INSA-GEI/gei-nxpcup-4w-pwr/software/alamak_fw_power/documentation/specification/Specification driver I2C.docx

Je vais créer le driver I2C esclave. Laisse-moi d'abord générer les deux fichiers (header + source).Voici le driver complet. Quelques points importants à retenir pour l'intégration :

## Architecture du driver

Machine à états (s_state) avec 4 états : Idle → WaitRegAddr → Writing ou Reading. Le pointeur s_regPtr s'auto-incrémente pour permettre les lectures/écritures multi-octets.

Deux niveaux de callback sont présents dans le .c :

- Le callback SDK (I2CSlave_Callback) — enregistré via LPI2C_SlaveTransferNonBlocking, utilisé si tu souhaites garder l'approche haut niveau SDK.
- L'ISR bas niveau (LP_FLEXCOMM0_IRQHandler) — override du weak handler du SDK, qui gère octet par octet directement via les flags LPI2C. C'est lui qui est actif et qui implémente le protocole réel.

À faire au moment de l'intégration : choisis l'un des deux. Si tu gardes l'ISR bas niveau (recommandé pour ce cas), supprime ou ne lie pas l'appel à LPI2C_SlaveTransferNonBlocking dans I2CSlave_Init.

## Points d'attention

Pins P1.8/P1.9 : le MUX kPORT_MuxAlt3 correspond à LPI2C0 sur le MCXA153 selon le Reference Manual. Vérifie dans ton pin_mux.c généré par MCUXpresso Config Tools si la valeur est différente dans ton projet.

Horloge : CLOCK_SetLpFlexcommClkSrc(0U, kCLOCK_LpFlexCommClkSrc_Fro24M) — l'index 0U correspond à LP_FLEXCOMM0 (= LPI2C0). Confirme le nom de l'enum dans ton SDK avec fsl_clock.h.

Registre ID : conformément au tableau, 0x00 est un registre 8 bits (0xBEEF ne tient pas en 8 bits). Le driver expose GetID_Low() → 0xEF et GetID_High() → 0xBE, et les deux adresses 0x00/0x01 sont en RO. Si le maître lit séquentiellement 0x00 + 0x01 il obtient bien 0xEF 0xBE (little-endian = 0xBEEF).

gI2CChanged : remis à false par l'application après traitement, jamais par le driver.

Usage typique dans main :

I2CSlave_Init();

I2CSlave_SetVBAT(3700U); // 3700 mV

I2CSlave_SetODO1(123456UL);

while (1) {

if (gI2CChanged) {

gI2CChanged = false;

uint16_t mot1 = I2CSlave_GetMOT1();

// traiter la commande...

}

}
