INSA-GEI/gei-nxpcup-4w-pwr/hardware/PDF/Capture du 2026-06-22 18-59-21.png

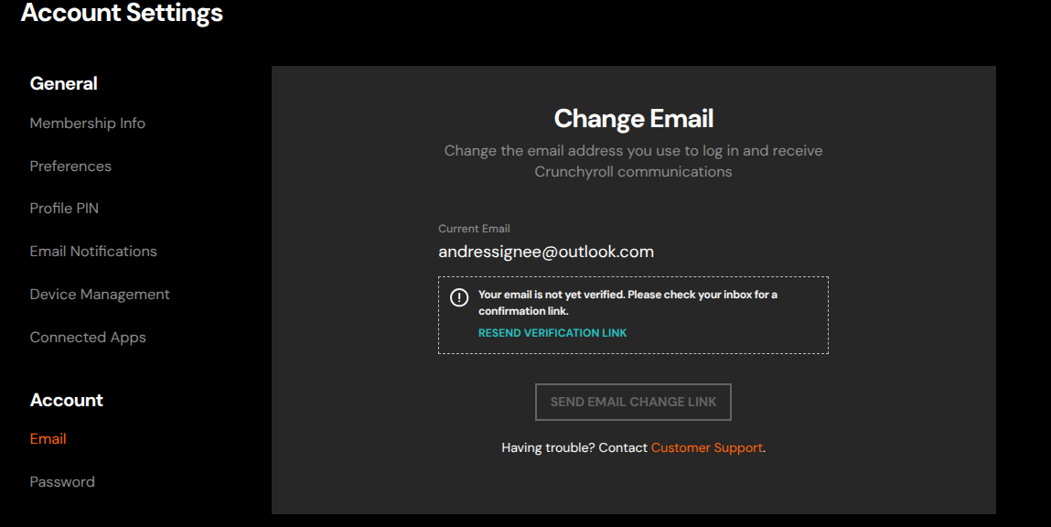
hardware/PDF/Capture du 2026-06-22 18-59-21.png
