INSA-GEI/gei-nxpcup-4w-pwr/hardware/PDF/IO.png

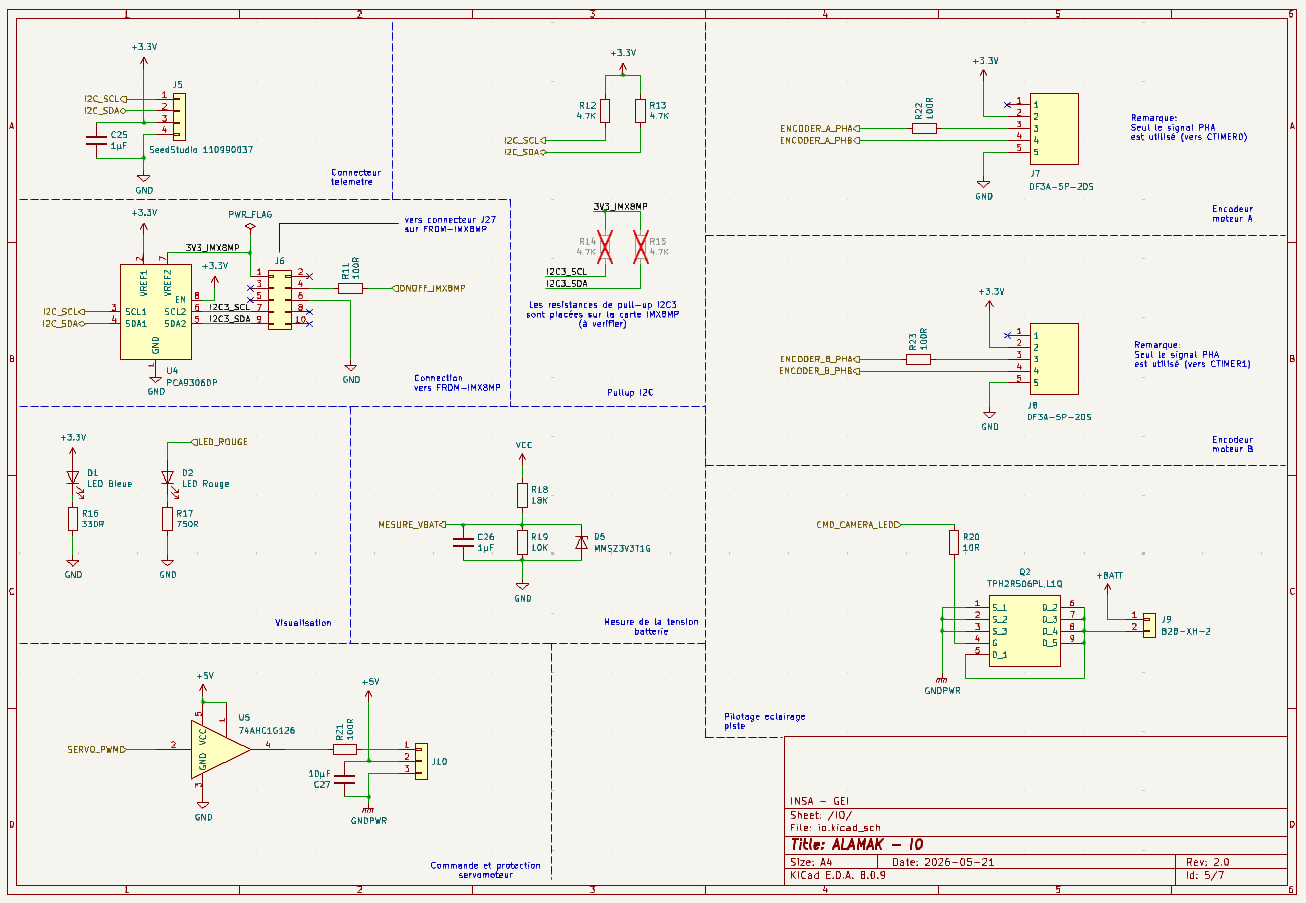
hardware/PDF/IO.png
