INSA-GEI/gei-nxpcup-4w-pwr/hardware/PDF/Puissance.png

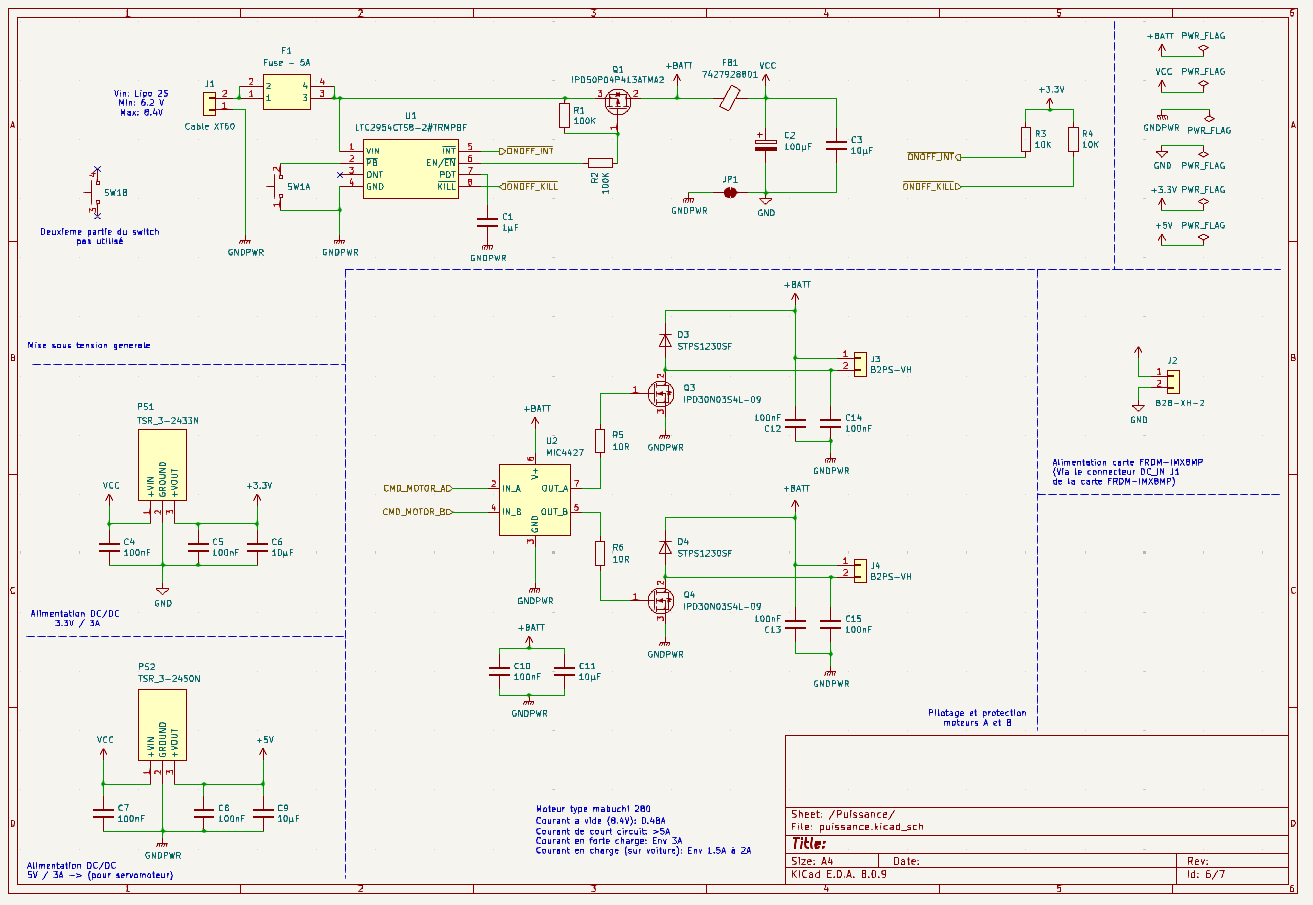
hardware/PDF/Puissance.png
