INSA-GEI/gei-nxpcup-4w-pwr/hardware/PDF/SysML.png

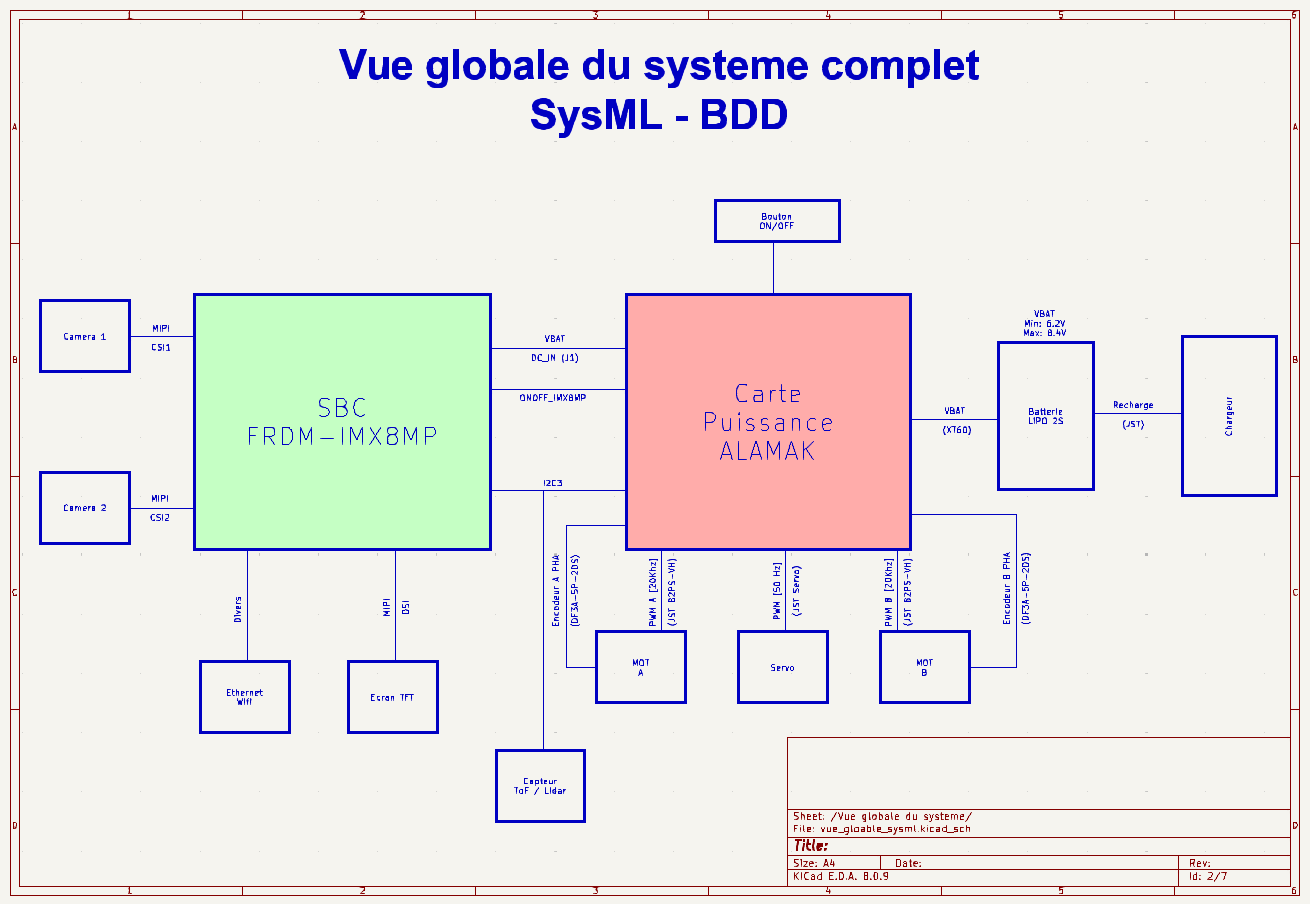
hardware/PDF/SysML.png
