INSA-GEI/gei-nxpcup-4w-pwr/PDF/Carte Alamak - vue globale.png

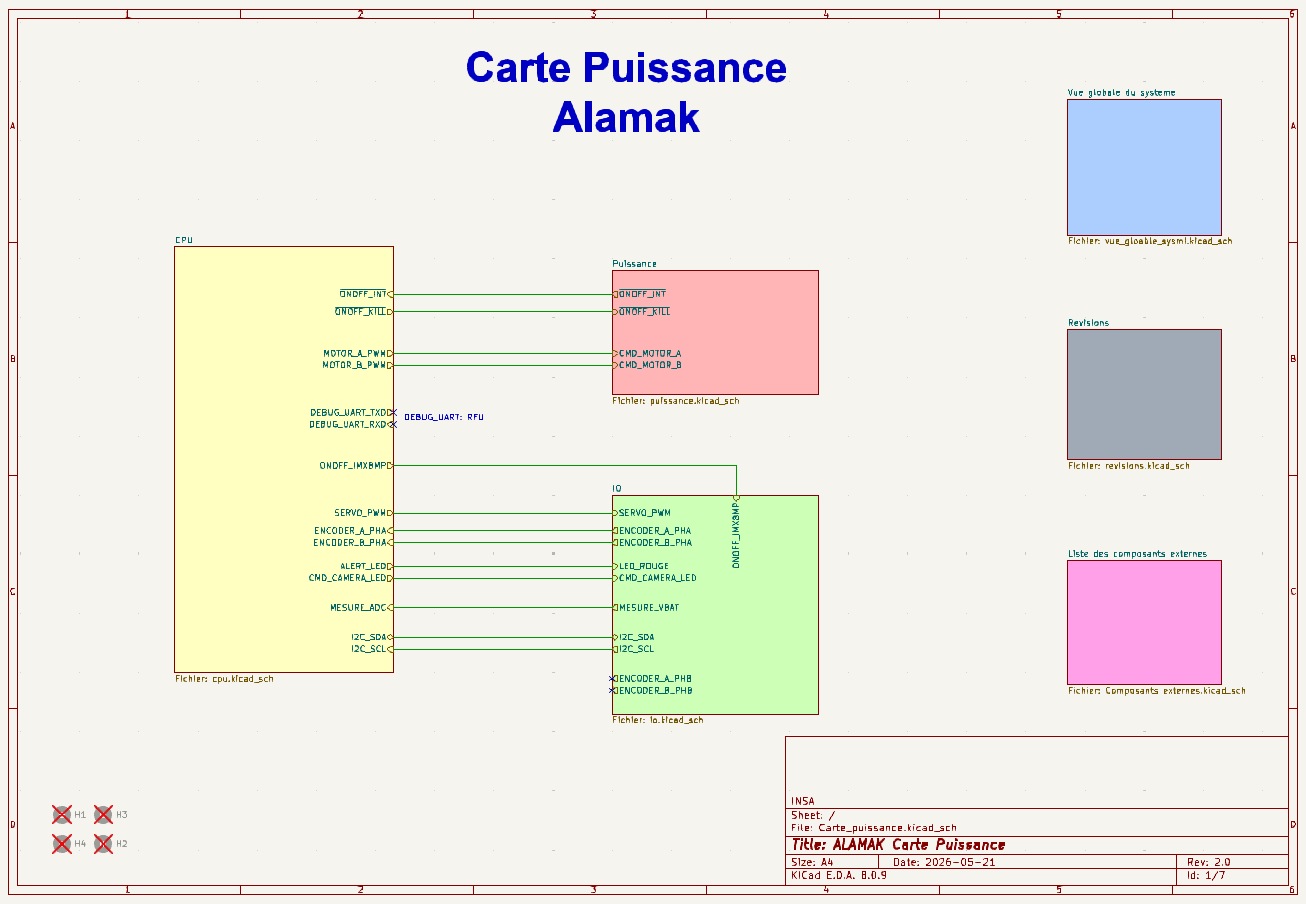
PDF/Carte Alamak - vue globale.png
