INSA-GEI/gei-nxpcup-4w-pwr/PDF/CPU.png

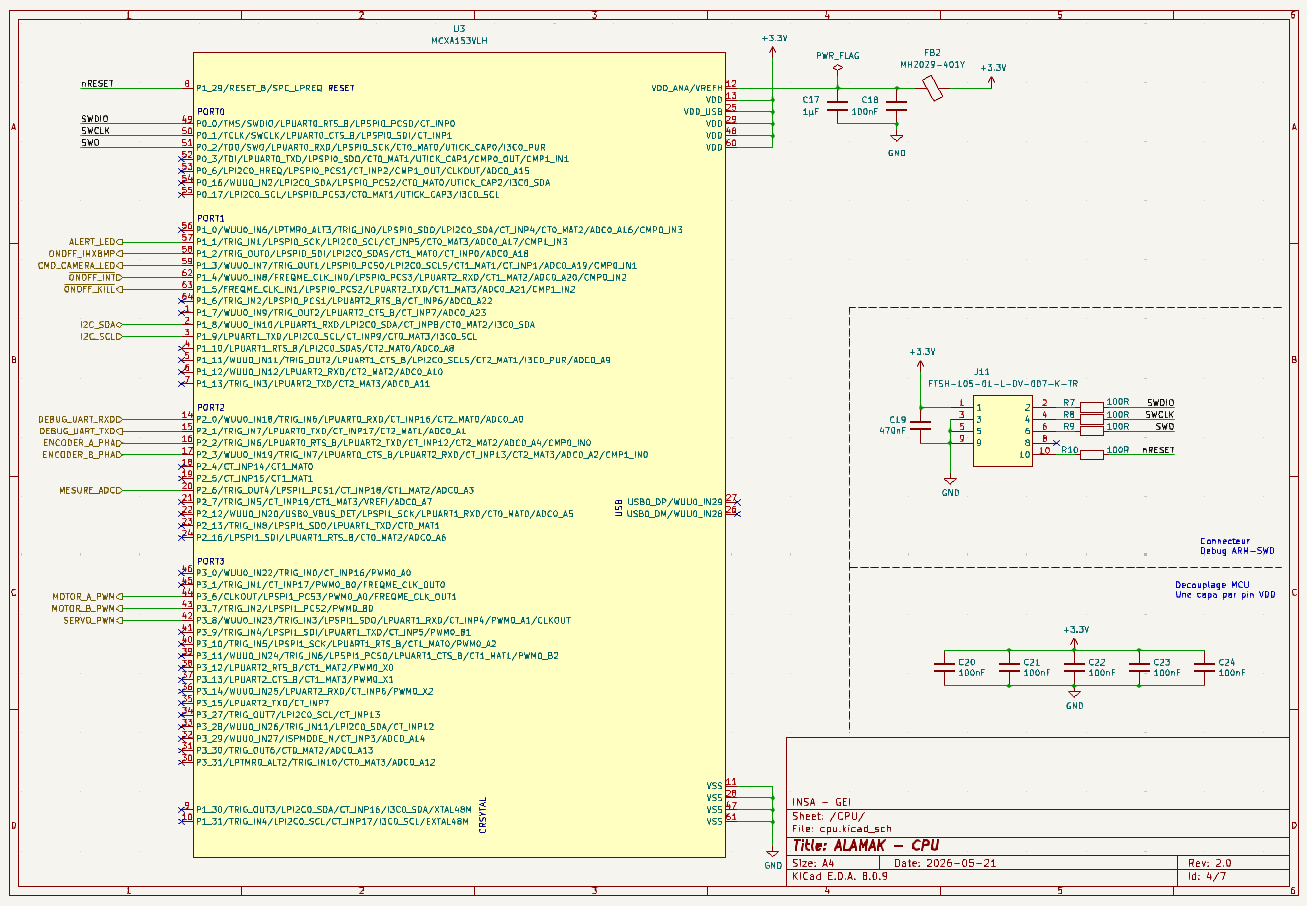
PDF/CPU.png
