INSA-GEI/gei-nxpcup-4w-pwr/PDF/Carte_puissance.pdf

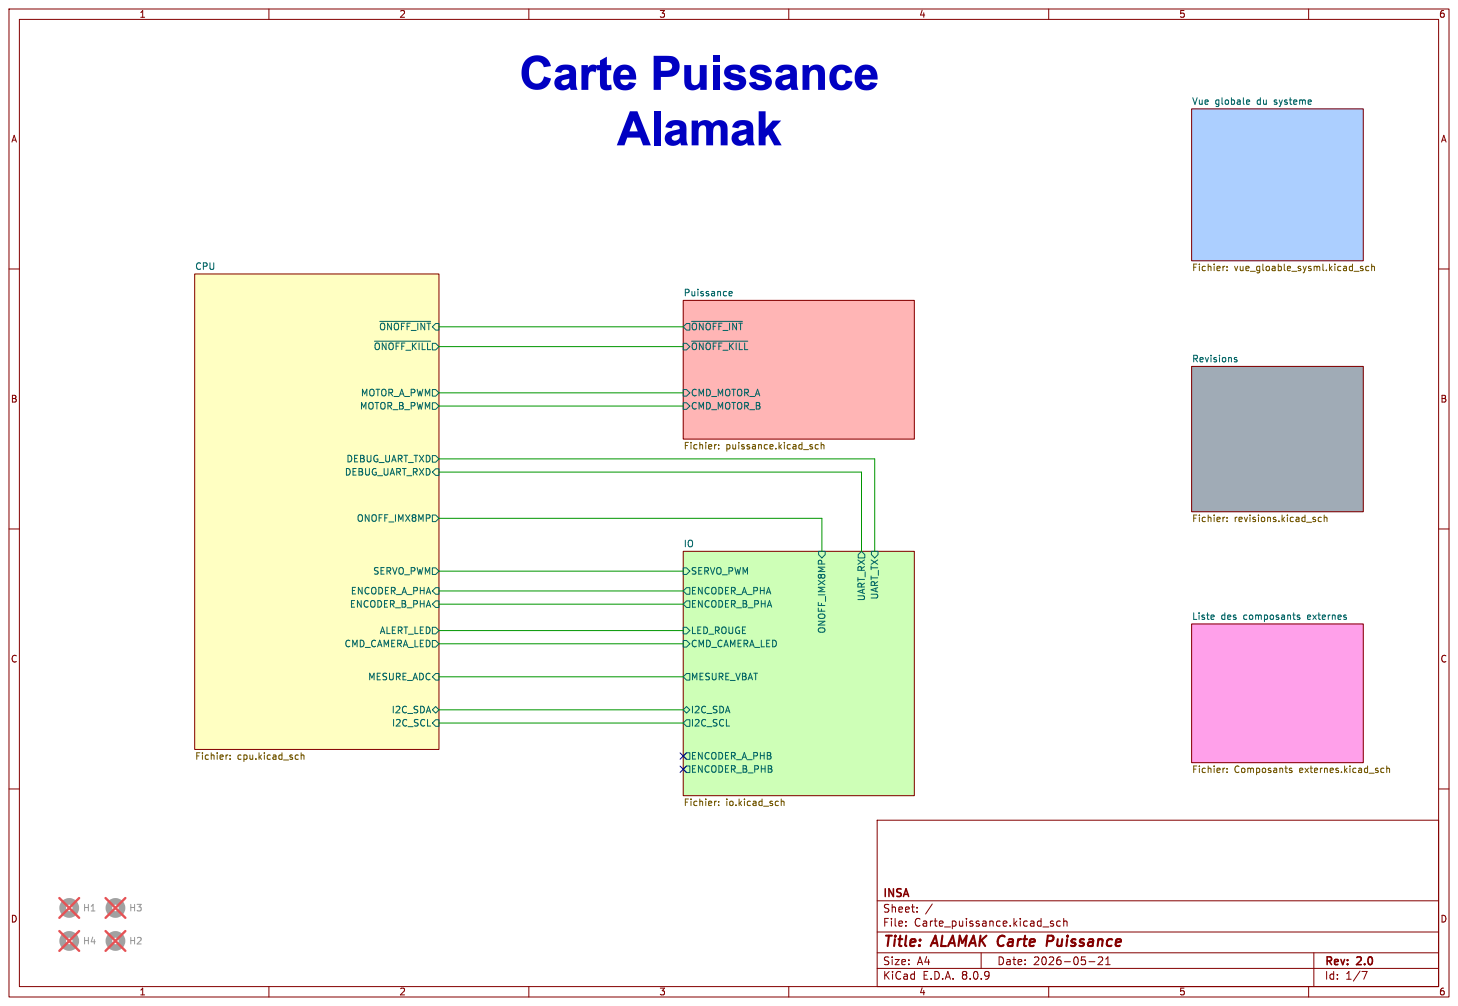
[picture p7: page 1]

INSA
File: Carte_puissance.kicad_sch Sheet: /
Id: 1/7 Title: ALAMAK Carte Puissance

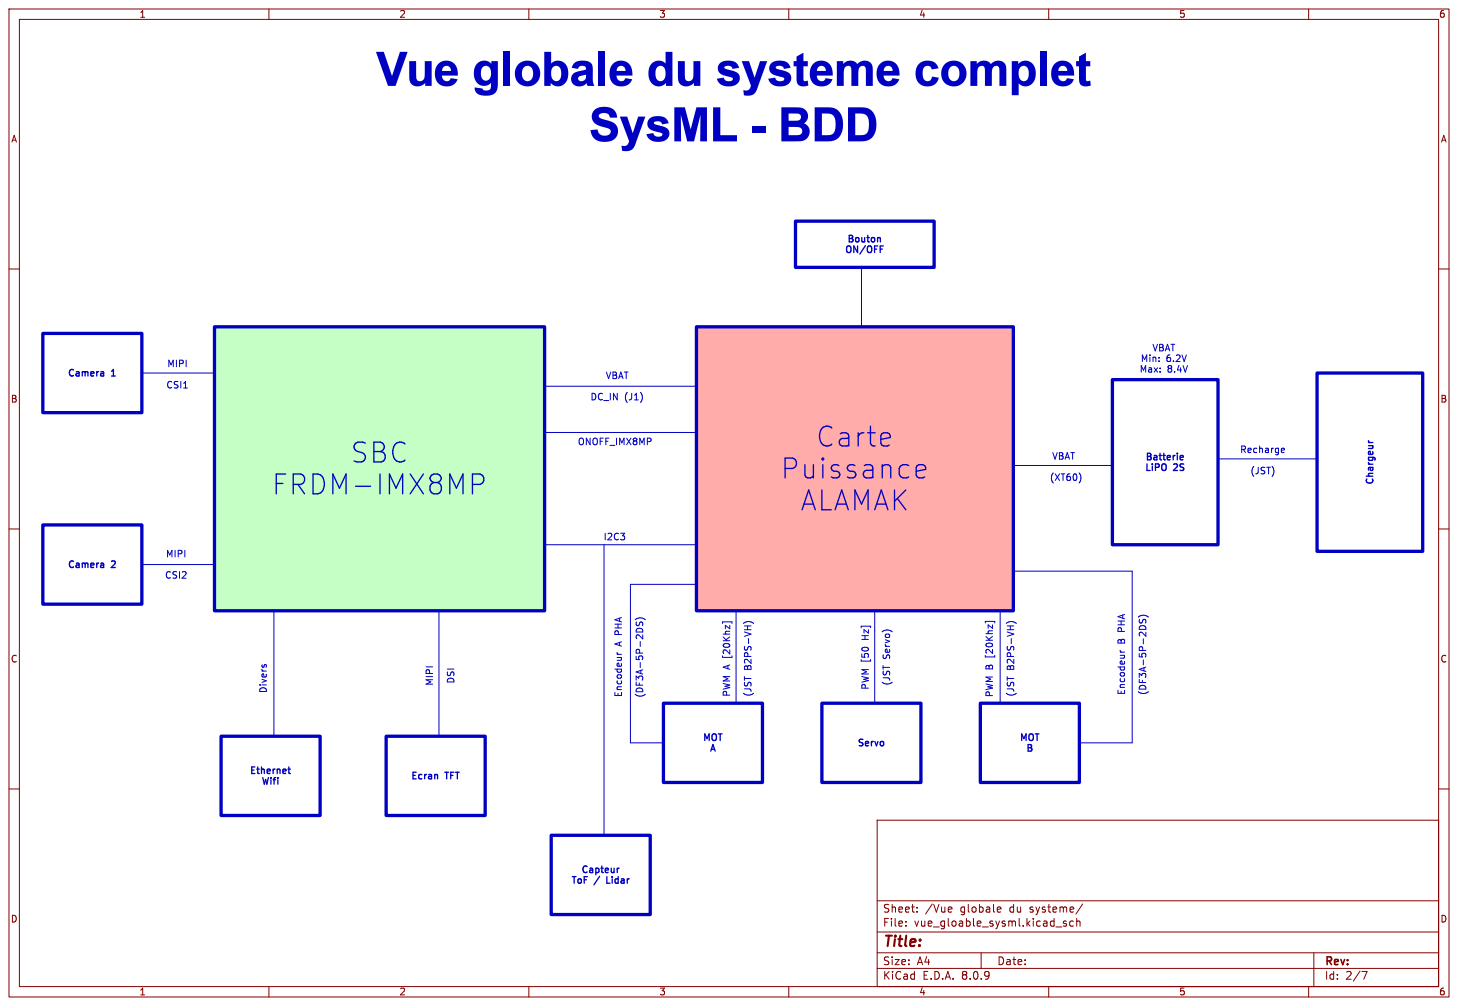
[picture p8: page 2]

(XT60) VBAT DC_IN (J1) ONOFF_IMX8MP Vue globale du systeme complet

(JST) VBAT Min: 6.2V Max: 8.4V

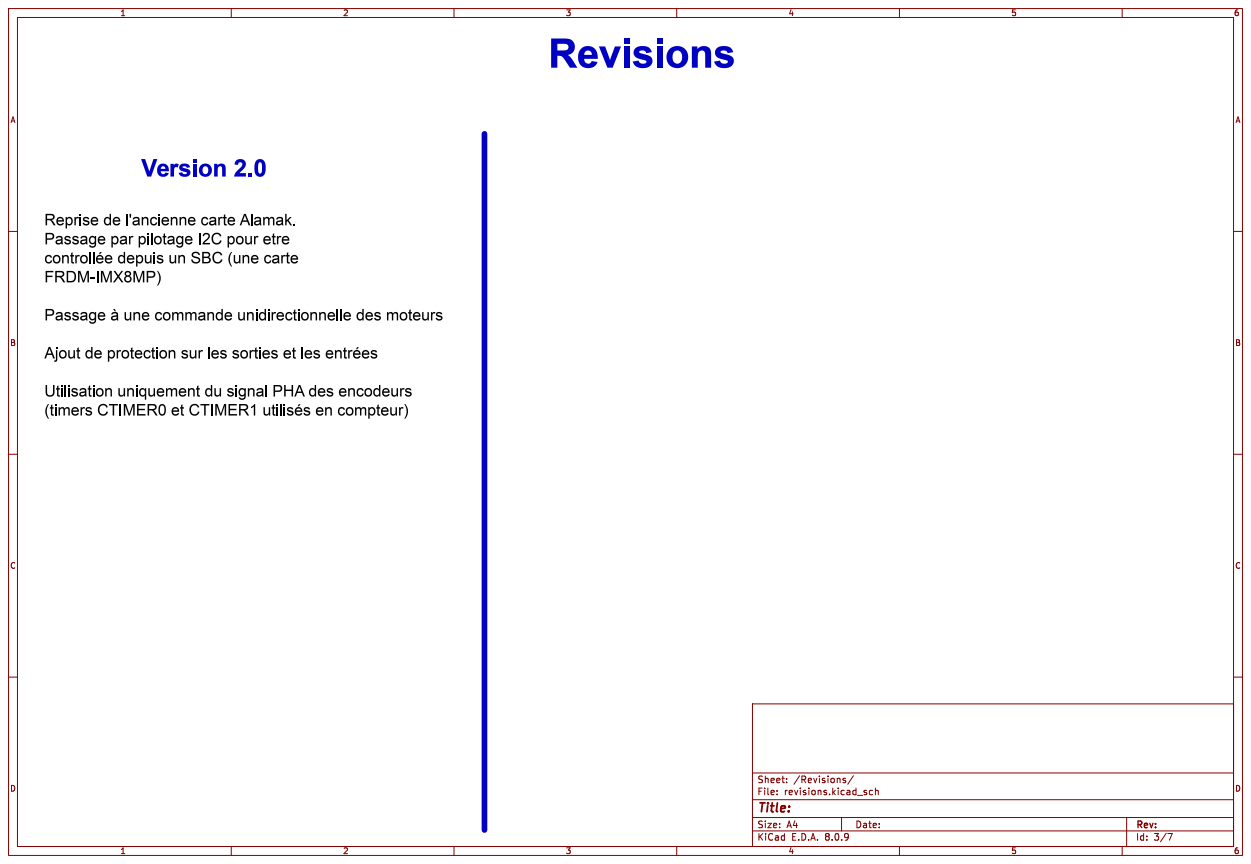
[picture p9: page 3]

Id: 3/7 Title: File: revisions.kicad_sch Sheet: /Revisions/ Reprise de l'ancienne carte Alamak.
Passage par pilotage I2C pour etre
þÿcontrollée depuis un SBC (une carte
FRDM-IMX8MP)

Passage þÿàune commande unidirectionnelle des moteurs

Ajout de protection sur les sorties et les þÿentrées

Utilisation uniquement du signal PHA des encodeurs
(timers CTIMER0 et CTIMER1 þÿutilisés en compteur)

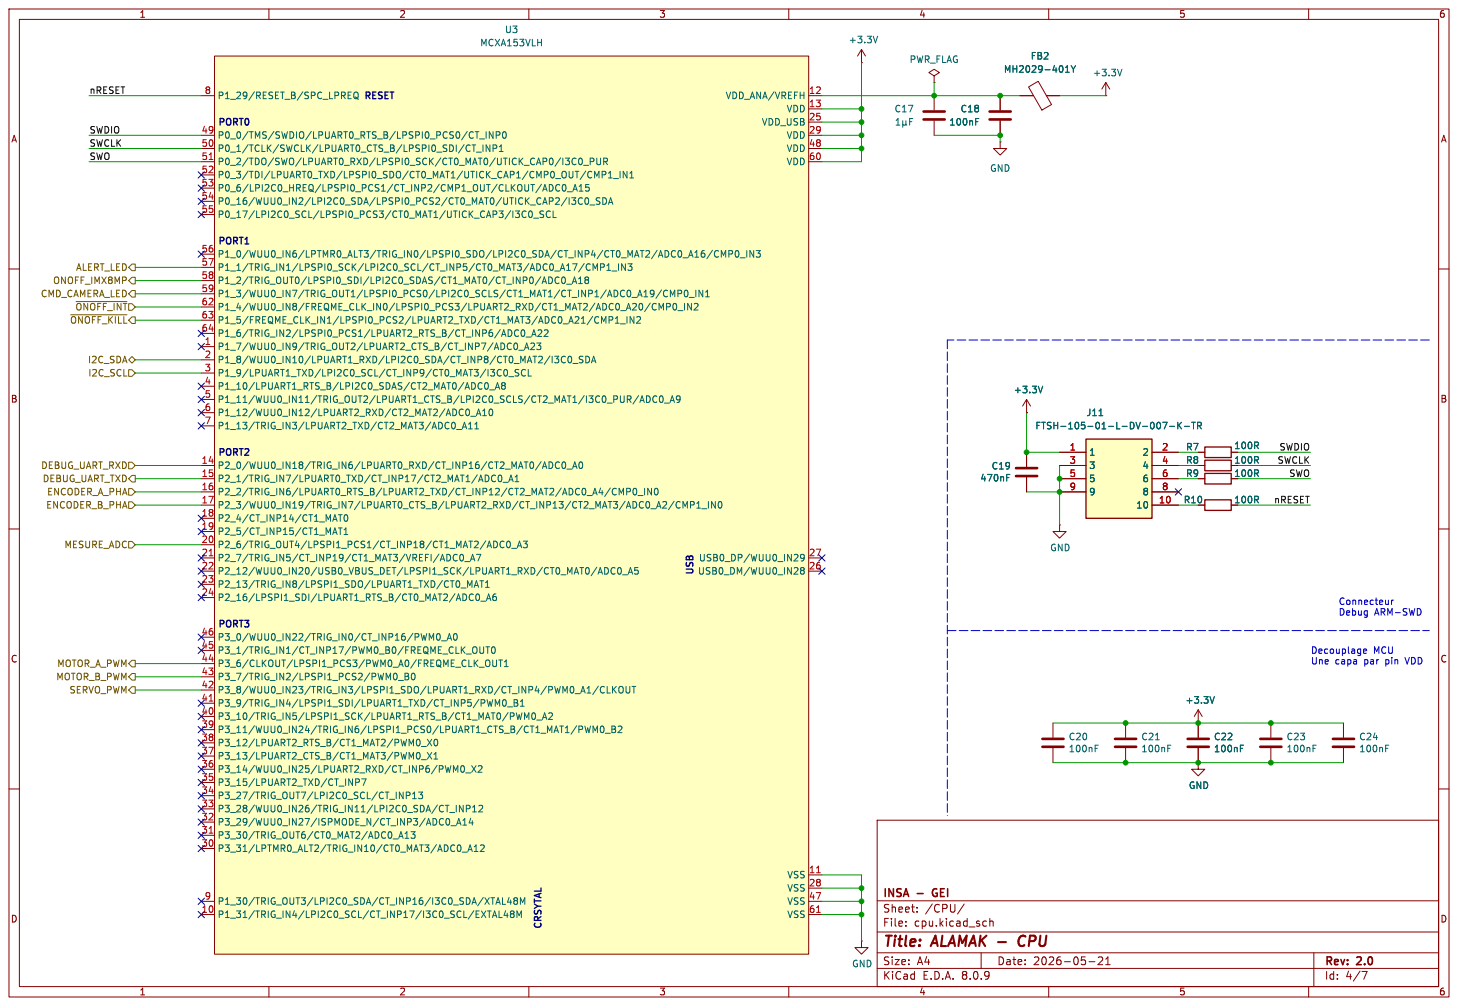
[picture p10: page 4]

Connecteur Debug ARM-SWD GND

Une capa par pin VDD

File: cpu.kicad_sch Sheet: /CPU/
Id: 4/7 Title: ALAMAK - CPU

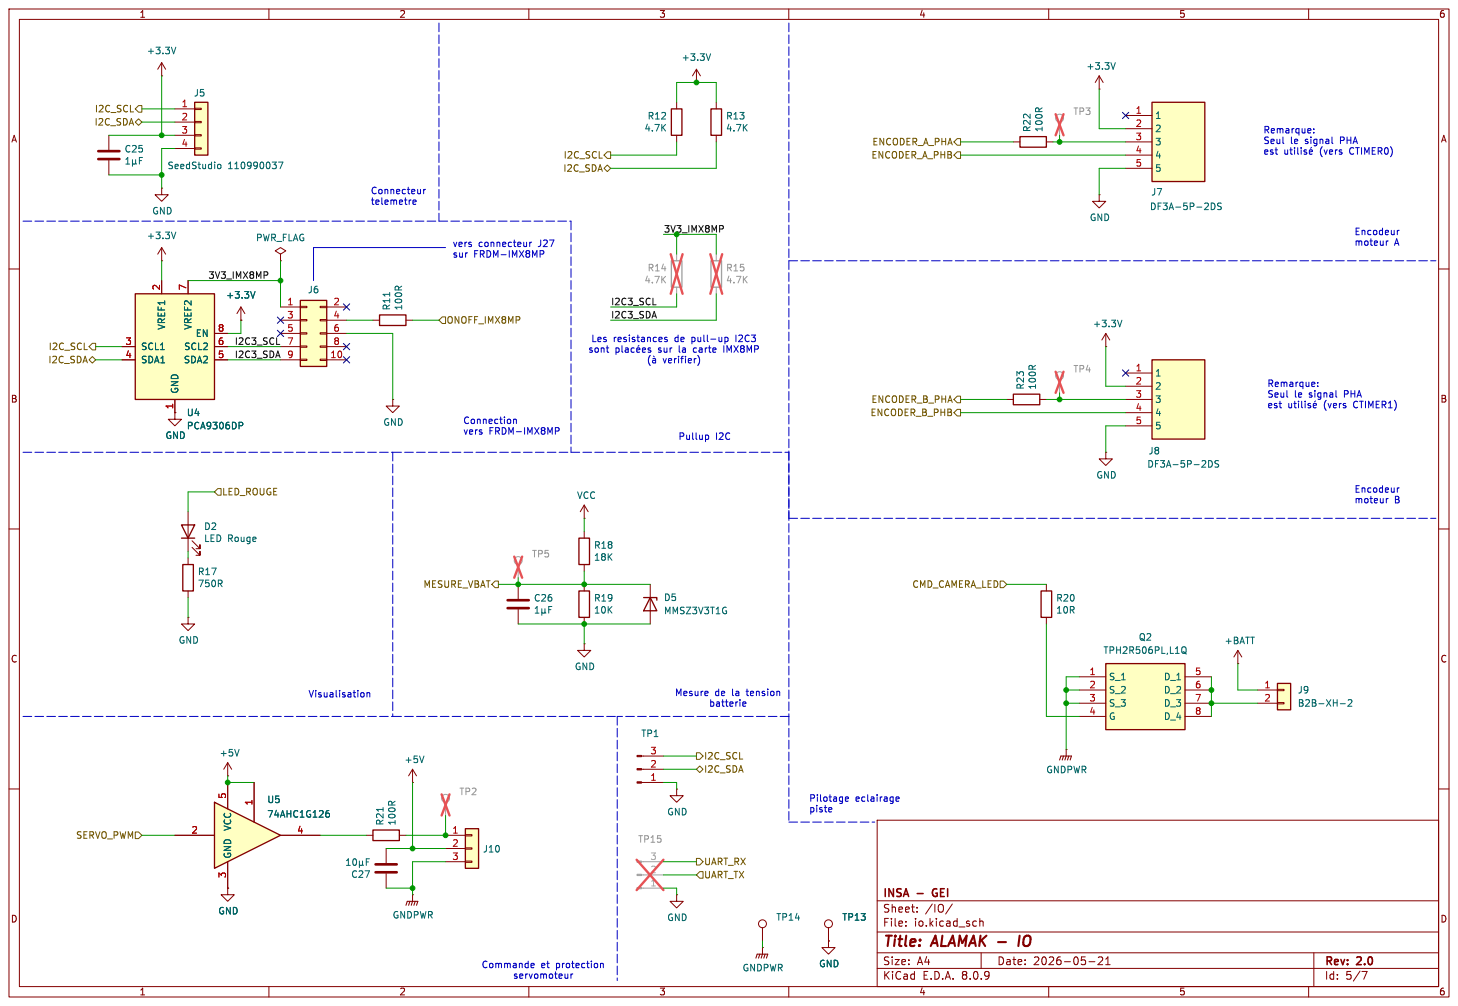
[picture p11: page 5]

Encodeur moteur A Remarque: Seul le signal PHA

sont þÿplacées sur la carte IMX8MP

Remarque: Seul le signal PHA

INSA - GEI
File: io.kicad_sch Sheet: /IO/
Id: 5/7 Title: ALAMAK - IO

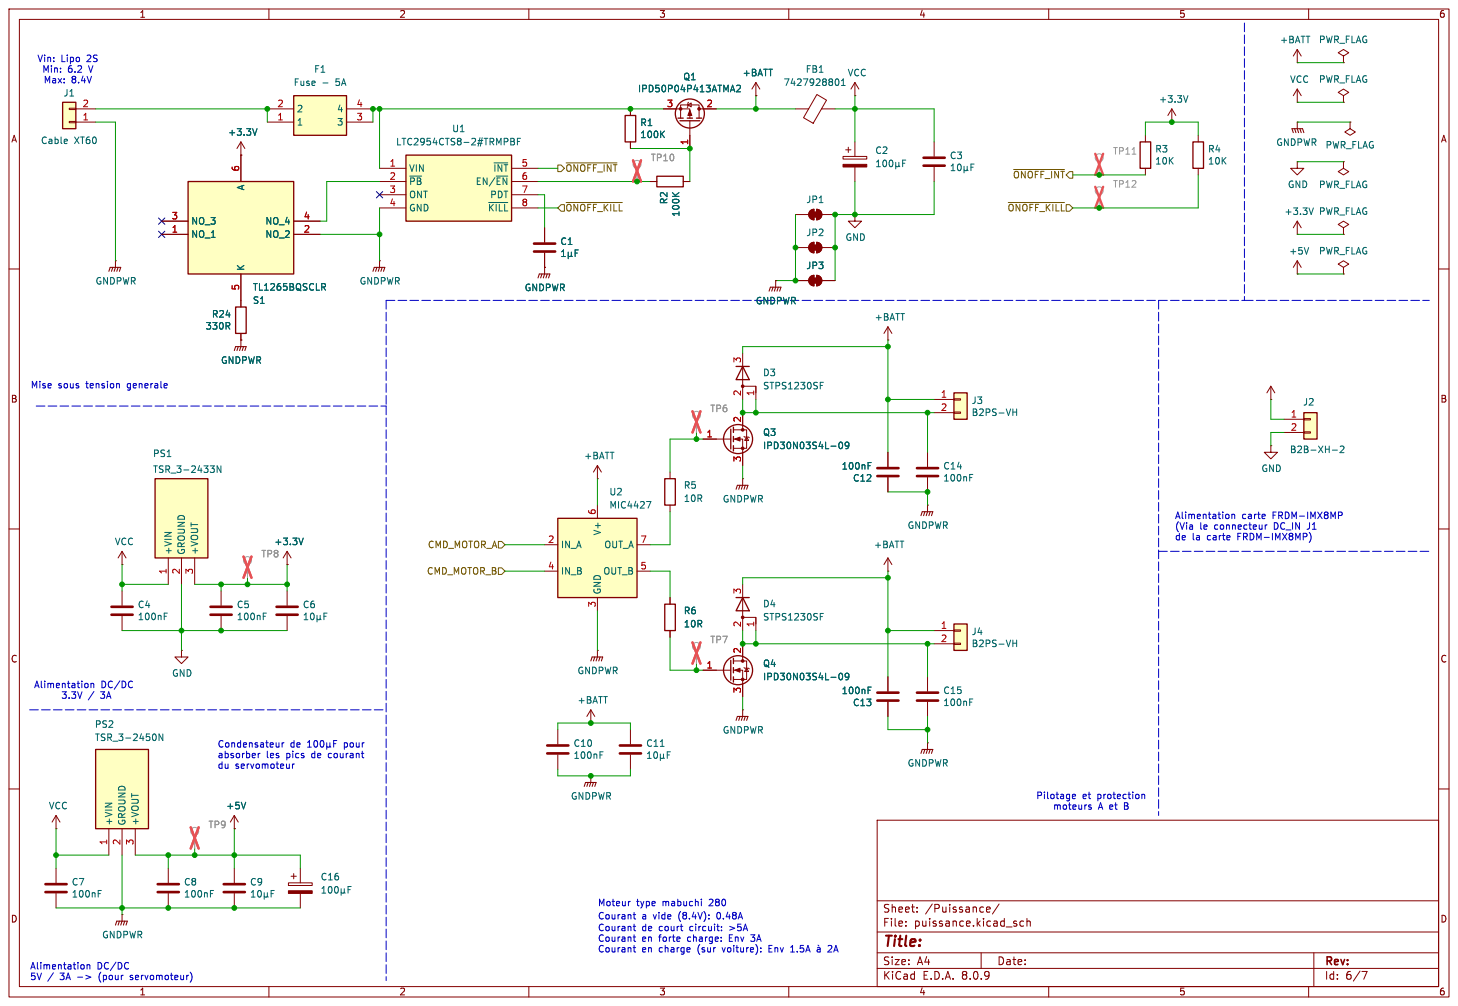
[picture p12: page 6]

6 OUT_A 7 U2 MIC4427 R6
Id: 6/7 Title: File: puissance.kicad_sch Sheet: /Puissance/ GNDPWR GNDPWR

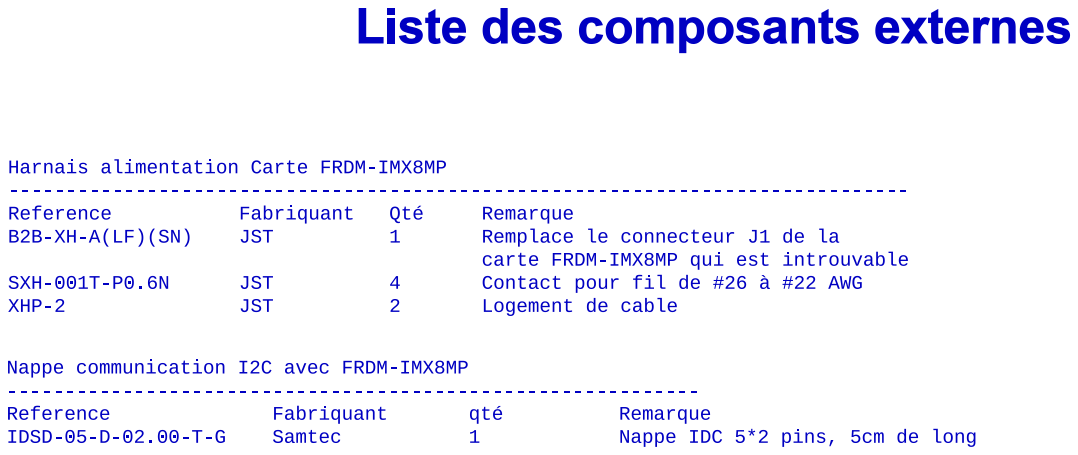
[picture p13: page 7]

Liste des composants externes
