INSA-GEI/gei-nxpcup-4w-pwr/hardware/PDF/PCB.pdf

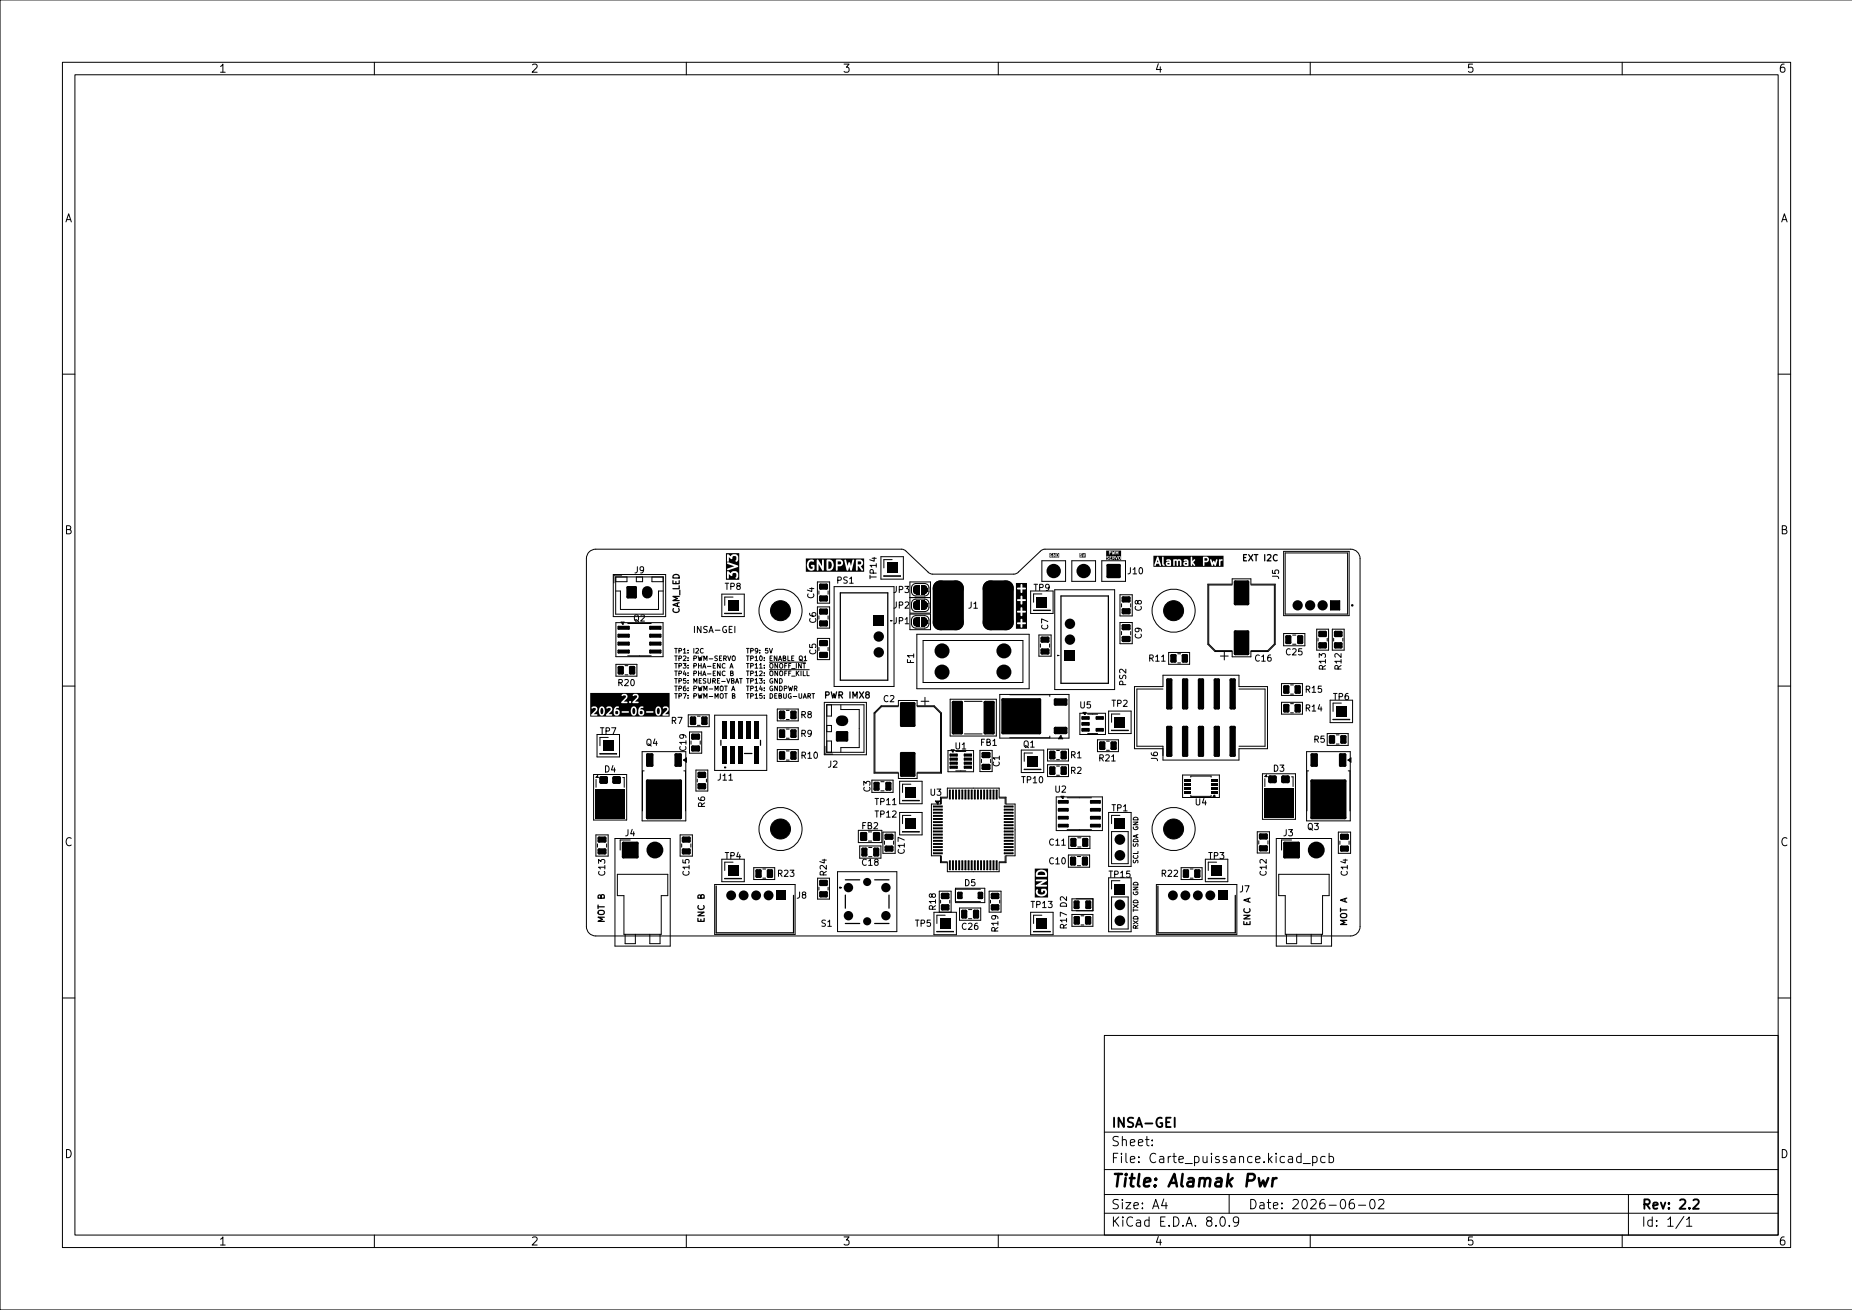
[picture p14: page 1]
