INSA-GEI/gei-nxpcup-4w-pwr/hardware/Carte_puissance.kicad_pcb

## KiCad design hardware/Carte_puissance.kicad_pcb (2026-10-14)

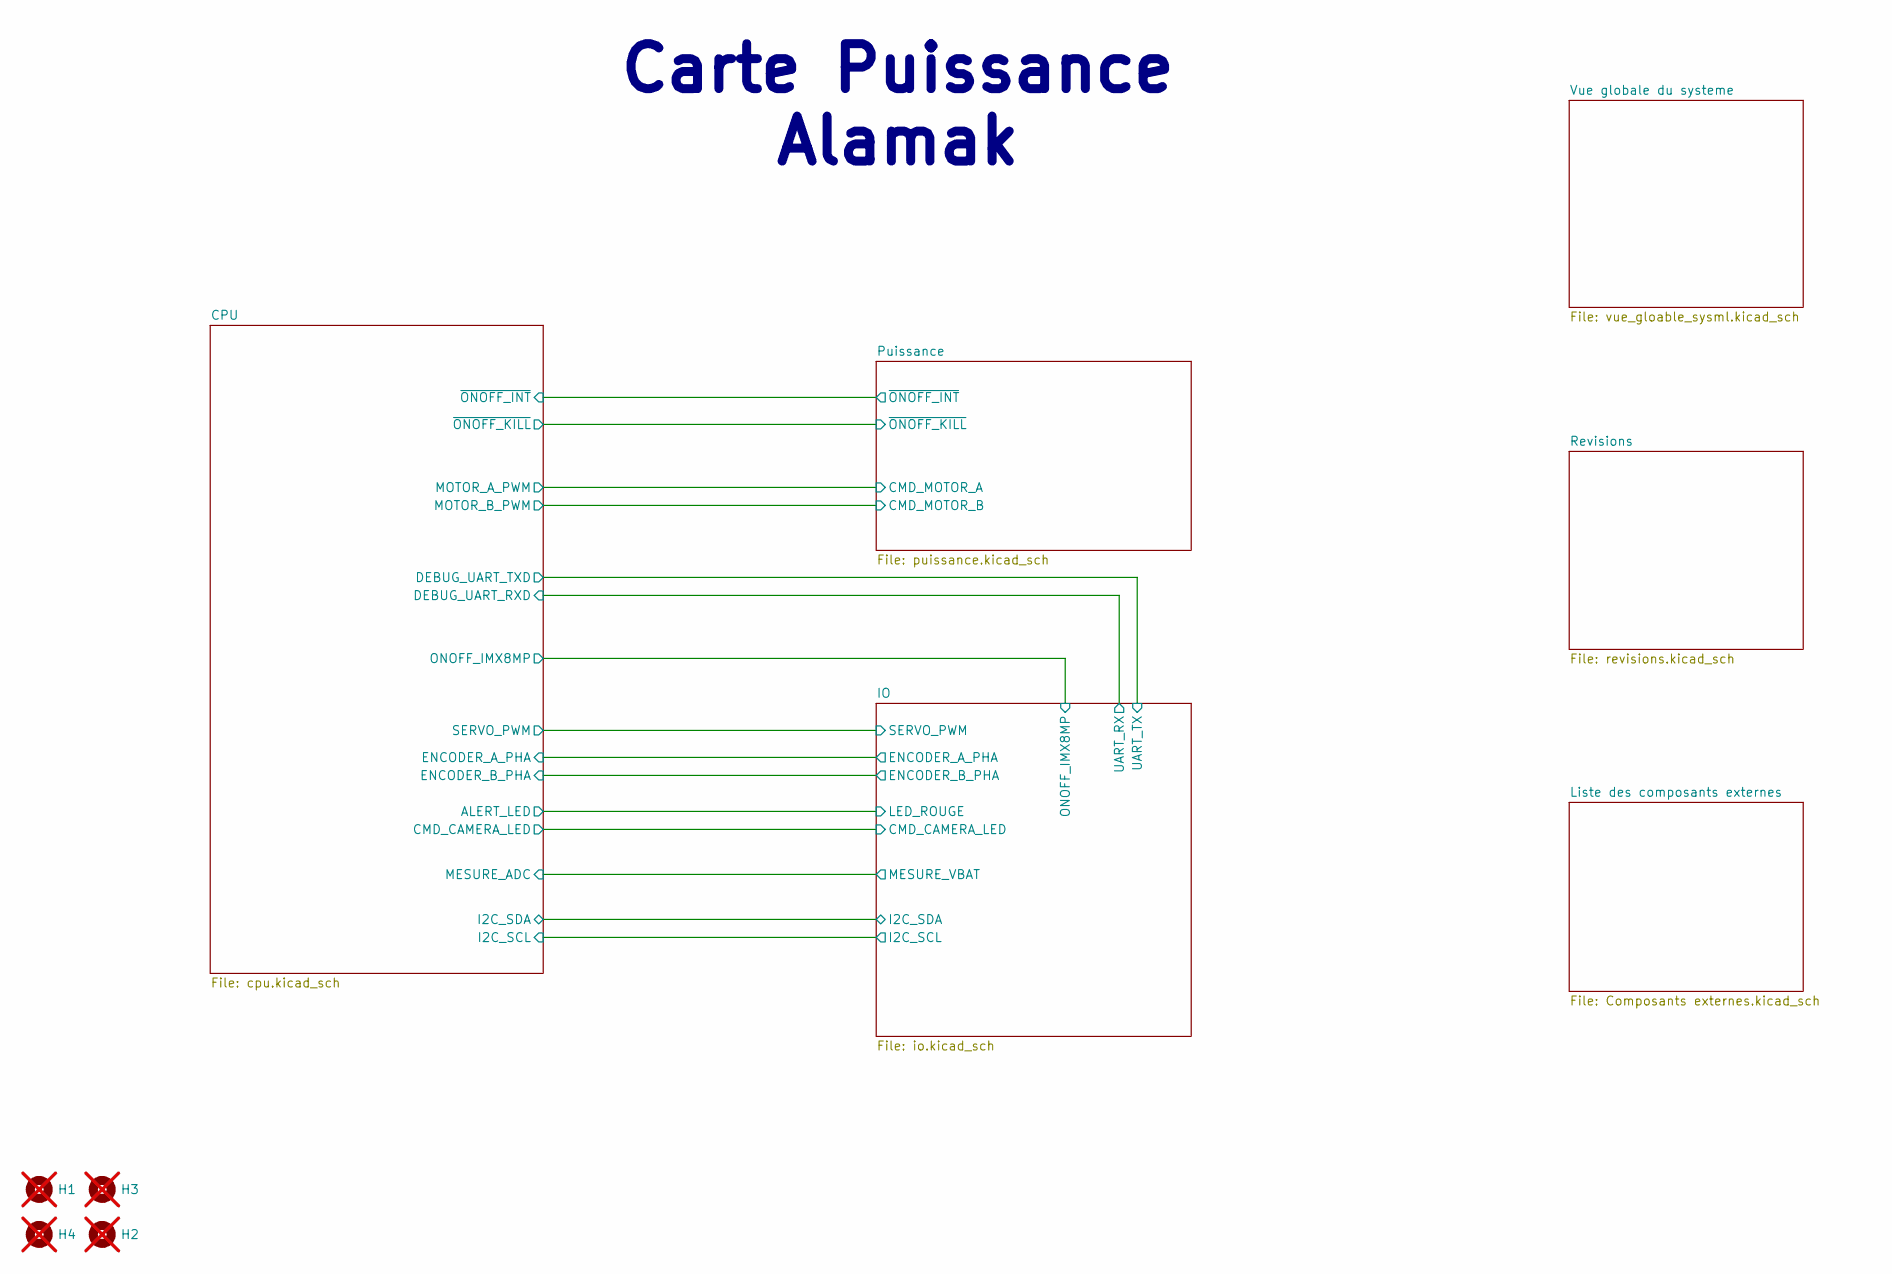
[picture p15: schematic Carte_puissance.kicad_sch, ALAMAK Carte Puissance]

Parts:
H1, H2, H3, H4: MountingHole; MountingHole_3.2mm_M3; not fitted

Notes on the sheet:
Carte Puissance Alamak

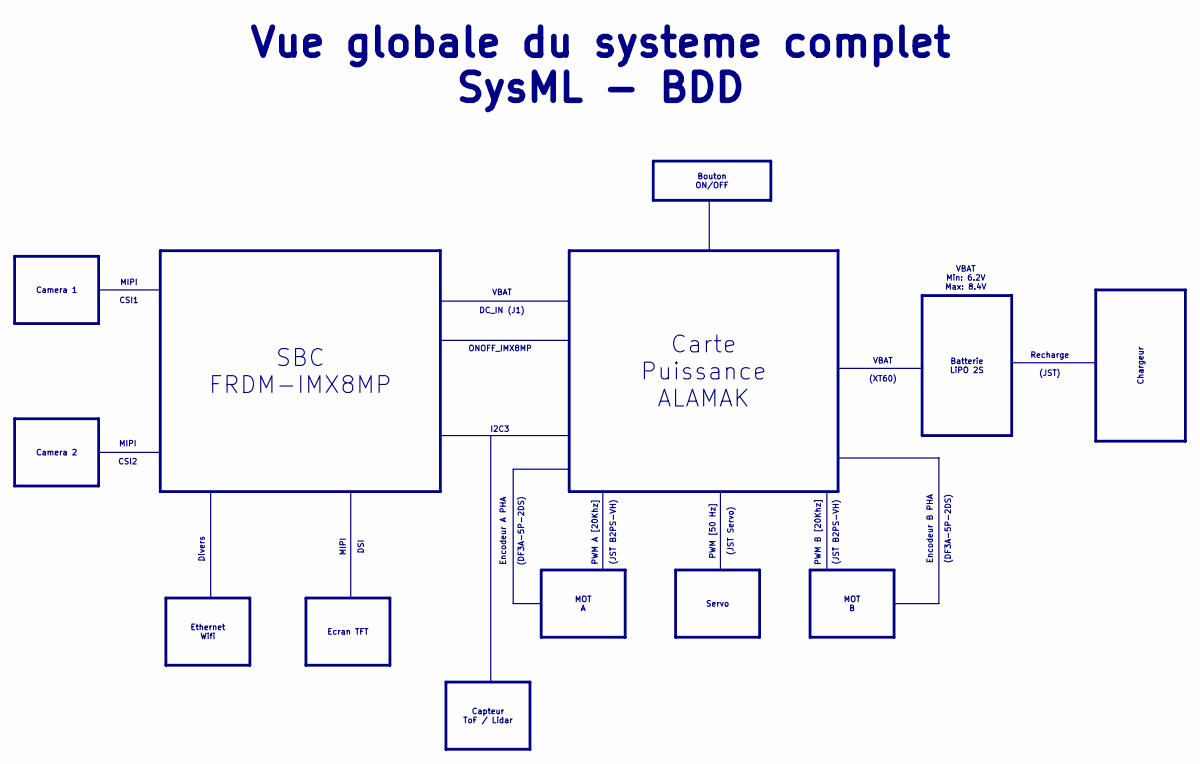
[picture p16: schematic vue_gloable_sysml.kicad_sch]

Notes on the sheet:
Chargeur
Servo
MOT A
MOT B
Ecran TFT
Batterie LiPO 2S
Capteur ToF / Lidar
Ethernet Wifi
SBC FRDM-IMX8MP
Camera 2
Camera 1
Carte Puissance ALAMAK
Bouton ON/OFF
PWM [50 Hz] (JST Servo)
VBAT Min: 6.2V Max: 8.4V
Vue globale du systeme complet SysML - BDD
Encodeur A PHA (DF3A-5P-2DS)
ONOFF_IMX8MP
PWM A [20Khz] (JST B2PS-VH)
MIPI CSI1
VBAT DC_IN (J1)
Divers
Recharge (JST)
VBAT (XT60)
Encodeur B PHA (DF3A-5P-2DS)
I2C3
MIPI CSI2
PWM B [20Khz] (JST B2PS-VH)
MIPI DSI

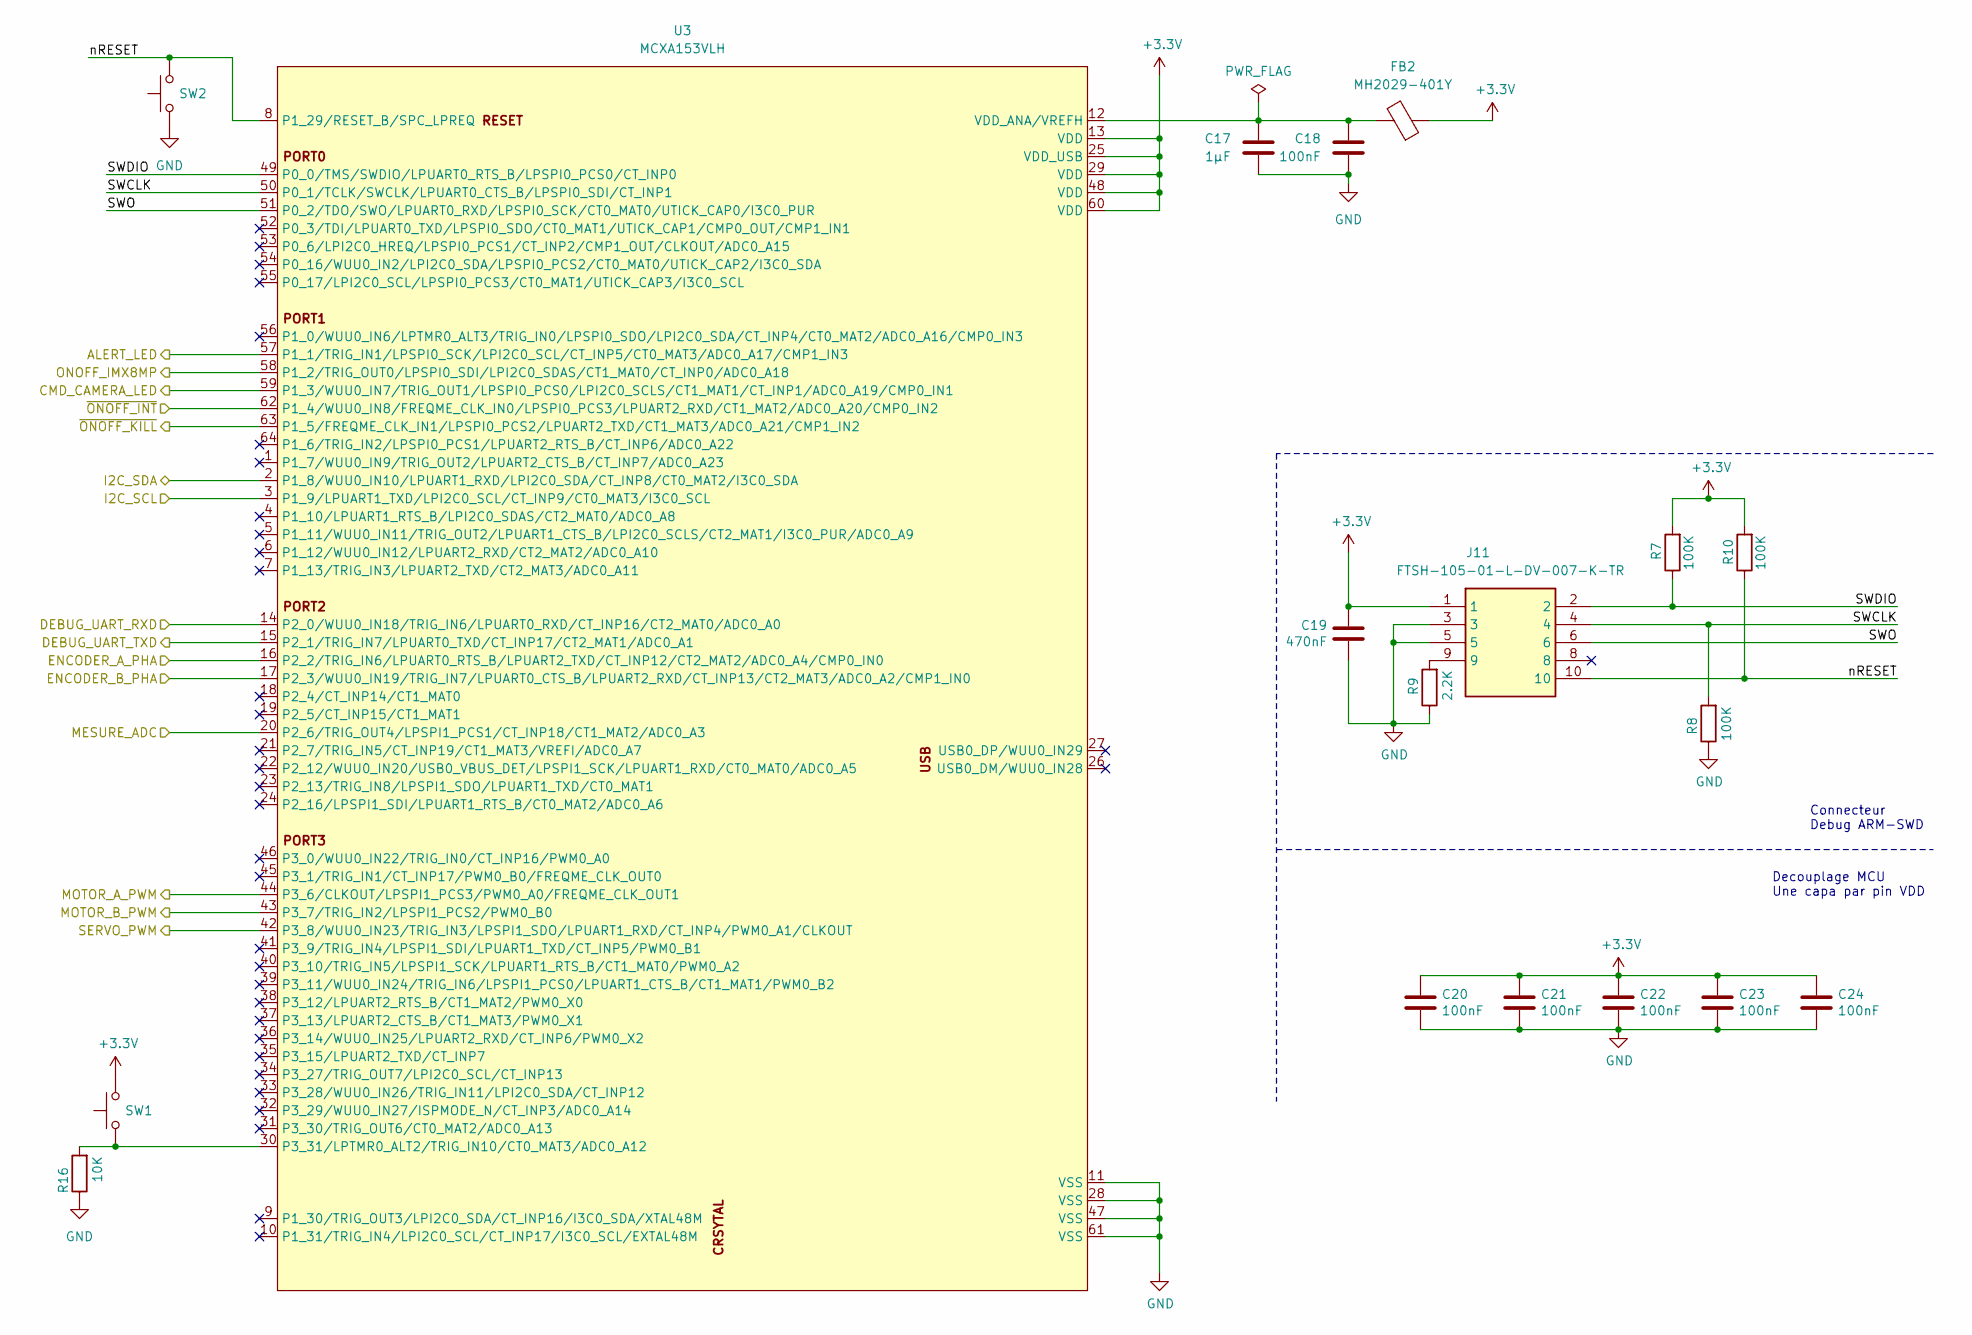
[picture p17: schematic cpu.kicad_sch, ALAMAK - CPU]

Parts:
C17: 1µF; C_0805_2012Metric; Part Number CL21B105KBFNNNF
C18, C20, C21, C22, C23, C24: 100nF; C_0805_2012Metric; Part Number CL21B104KBFNNNG
C19: 470nF; C_0805_2012Metric; Part Number CL21B474KBFNNNG
FB2: MH2029-401Y; C_0805_2012Metric_Pad1.18x1.45mm_HandSolder; Part Number MH2029-401Y
J11: FTSH-105-01-L-DV-007-K-TR; FTSH10501LDV007KTR; Part Number FTSH-105-01-L-DV-007-K-TR
R7, R8, R10: 100K; R_0805_2012Metric; Part Number RT0805FRE10100KL
R9: 2.2K; R_0805_2012Metric; Part Number RT0805FRE132K2L
R16: 10K; R_0805_2012Metric; Part Number RCA080510K0JNEASR
SW1, SW2: EVQ-P2602M; SW_SPST_EVQP2; Part Number EVQ-P2602M
U3: MCXA153VLH; LQFP-64_10x10mm_P0.5mm; Part Number MCXA153VLH

Connections:
+3.3V: C19.1, C20.1, C21.1, C22.1, C23.1, C24.1, FB2.1, J11.1, R7.2, R10.2, SW1.2, U3.13 (VDD), U3.25 (VDD_USB), U3.29 (VDD), U3.48 (VDD), U3.60 (VDD); also elsewhere on the board
/CPU/ALERT_LED: U3.57 (P1_1/TRIG_IN1/LPSPI0_SCK/LPI2C0_SCL/CT_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); also elsewhere on the board
/CPU/CMD_CAMERA_LED: U3.59 (P1_3/WUU0_IN7/TRIG_OUT1/LPSPI0_PCS0/LPI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); also elsewhere on the board
/CPU/DEBUG_UART_RXD: U3.14 (P2_0/WUU0_IN18/TRIG_IN6/LPUART0_RXD/CT_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); also elsewhere on the board
/CPU/DEBUG_UART_TXD: U3.15 (P2_1/TRIG_IN7/LPUART0_TXD/CT_INP17/CT2_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); also elsewhere on the board
/CPU/ENCODER_A_PHA: U3.16 (P2_2/TRIG_IN6/LPUART0_RTS_B/LPUART2_TXD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); also elsewhere on the board
/CPU/ENCODER_B_PHA: U3.17 (P2_3/WUU0_IN19/TRIG_IN7/LPUART0_CTS_B/L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); also elsewhere on the board
/CPU/I2C_SCL: U3.3 (P1_9/LPUART1_TXD/LPI2C0_SCL/CT_INP9/CT0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); also elsewhere on the board
/CPU/I2C_SDA: U3.2 (P1_8/WUU0_IN10/LPUART1_RXD/LPI2C0_SDA/C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); also elsewhere on the board
/CPU/MESURE_ADC: U3.20 (P2_6/TRIG_OUT4/LPSPI1_PCS1/CT_INP18/CT1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); also elsewhere on the board
/CPU/MOTOR_A_PWM: U3.44 (P3_6/CLKOUT/LPSPI1_PCS3/PWM0_A0/FREQME_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); also elsewhere on the board
/CPU/MOTOR_B_PWM: U3.43 (P3_7/TRIG_IN2/LPSPI1_PCS2/PWM0_B0); also elsewhere on the board
/CPU/ONOFF_IMX8MP: U3.58 (P1_2/TRIG_OUT0/LPSPI0_SDI/LPI2C0_SDAS/C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); also elsewhere on the board
/CPU/SERVO_PWM: U3.42 (P3_8/WUU0_IN23/TRIG_IN3/LPSPI1_SDO/LPUA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); also elsewhere on the board
/CPU/SWCLK: J11.4, R8.2, U3.50 (P0_1/TCLK/SWCLK/LPUART0_CTS_B/LPSPI0_SD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)
/CPU/SWDIO: J11.2, R7.1, U3.49 (P0_0/TMS/SWDIO/LPUART0_RTS_B/LPSPI0_PCS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)
/CPU/SWO: J11.6, U3.51 (P0_2/TDO/SWO/LPUART0_RXD/LPSPI0_SCK/CT0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)
/CPU/nRESET: J11.10, R10.1, SW2.2, U3.8 (P1_29/RESET_B/SPC_LPREQ)
/CPU/~ONOFF_INT: U3.62 (P1_4/WUU0_IN8/FREQME_CLK_IN0/LPSPI0_PCS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); also elsewhere on the board
/CPU/~ONOFF_KILL: U3.63 (P1_5/FREQME_CLK_IN1/LPSPI0_PCS2/LPUART2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); also elsewhere on the board
GND: C17.2, C18.2, C19.2, C20.2, C21.2, C22.2, C23.2, C24.2, J11.3, J11.5, R8.1, R9.1, R16.1, SW2.1, U3.11 (VSS), U3.28 (VSS), U3.47 (VSS), U3.61 (VSS); also elsewhere on the board
unnamed: J11.9, R9.2
unnamed: R16.2, SW1.1, U3.30 (P3_31/LPTMR0_ALT2/TRIG_IN10/CT0_MAT3/AD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)
unnamed: C17.1, C18.1, FB2.2, U3.12 (VDD_ANA/VREFH)

Notes on the sheet:
Decouplage MCU Une capa par pin VDD
Connecteur Debug ARM-SWD

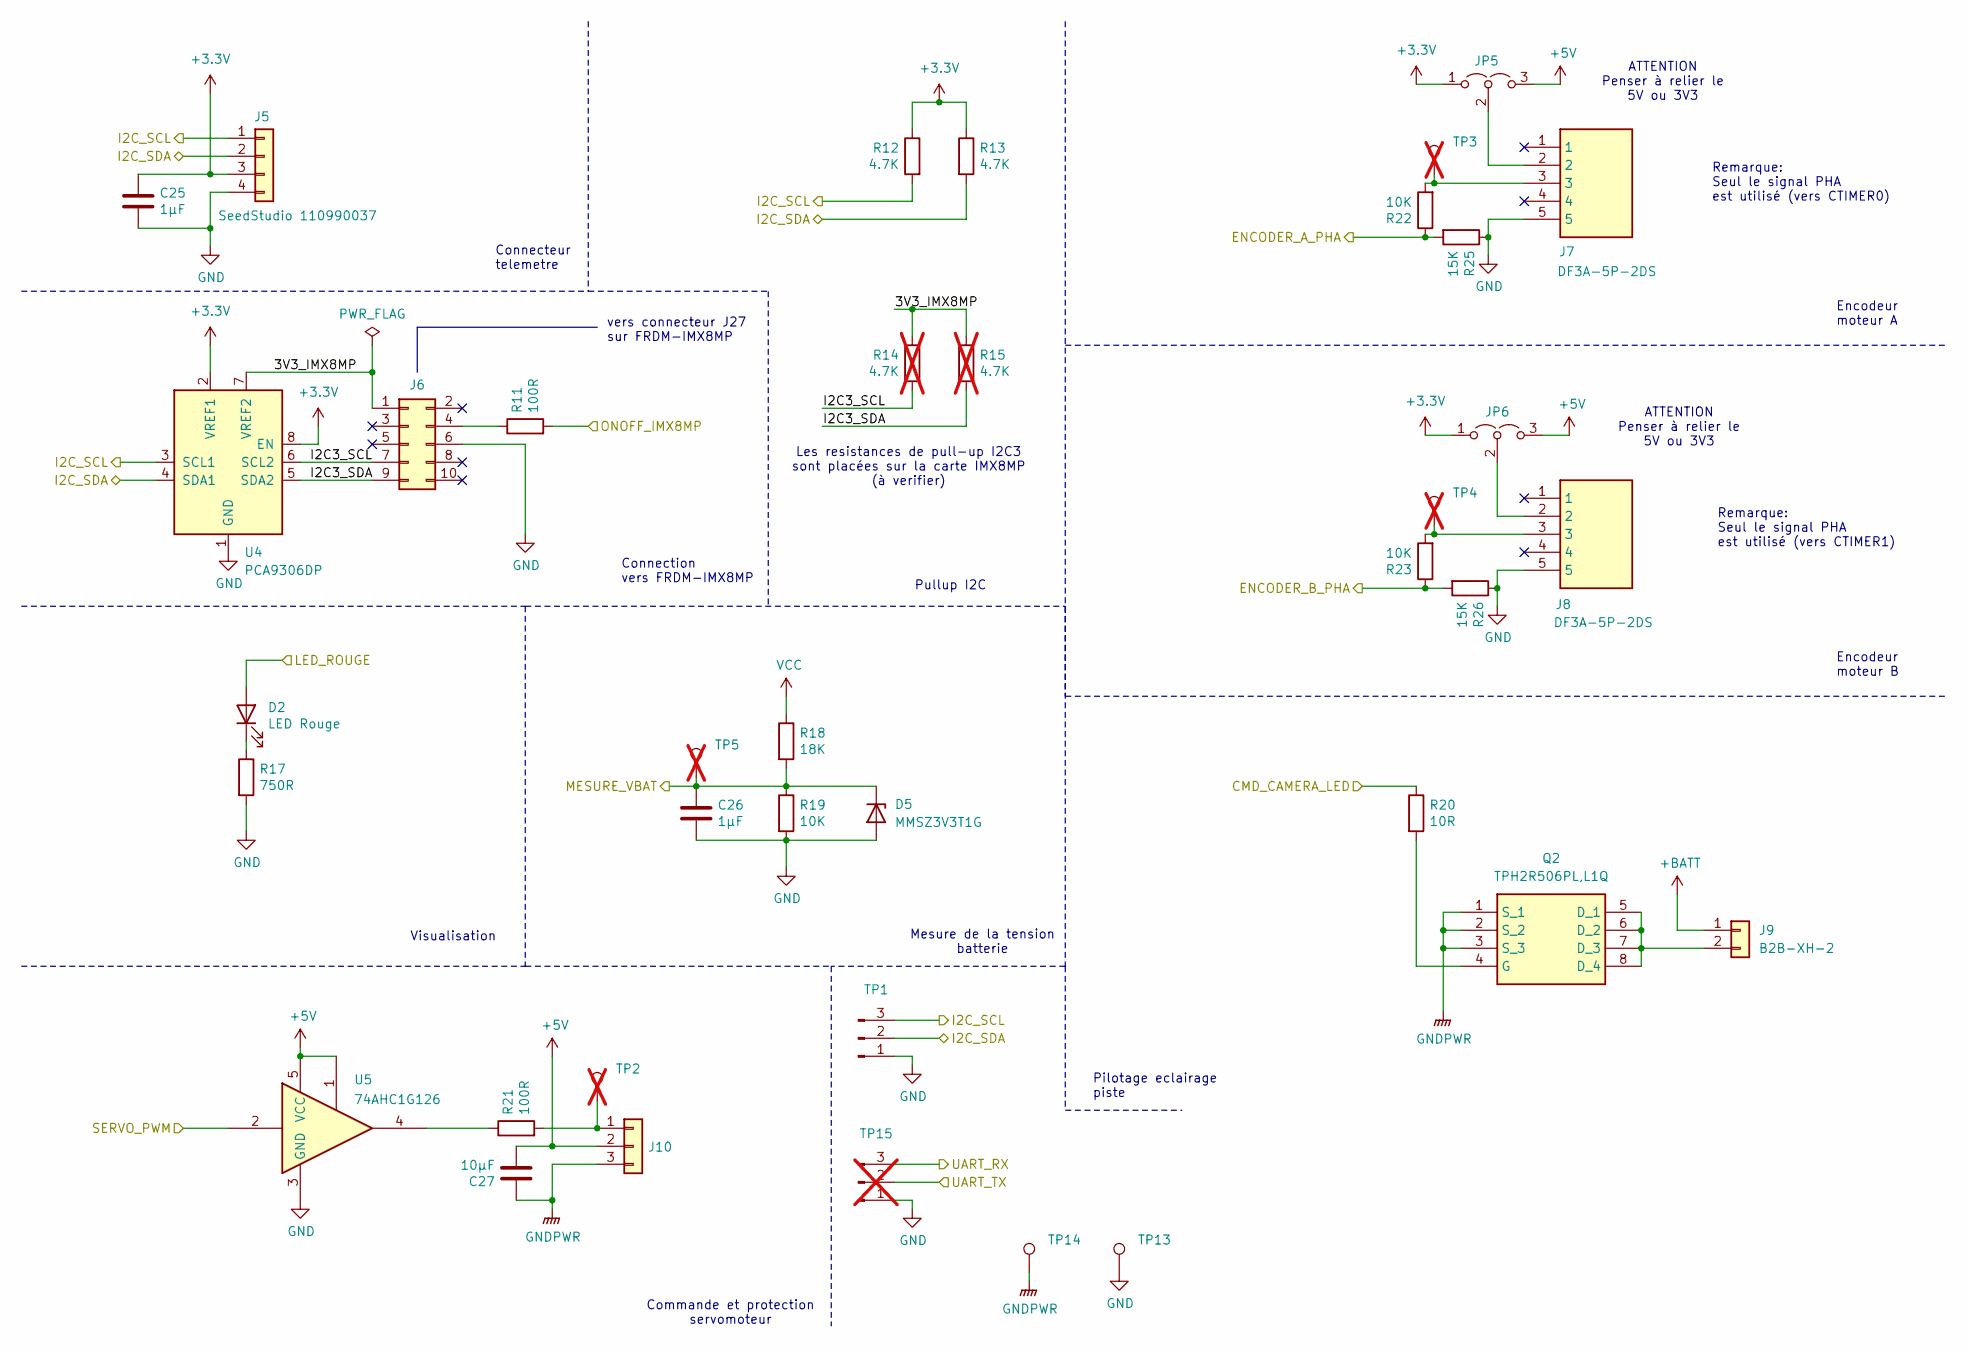
[picture p18: schematic io.kicad_sch, ALAMAK - IO]

Parts:
C25, C26: 1µF; C_0805_2012Metric; Part Number CL21B105KBFNNNF
C27: 10µF; C_0805_2012Metric; Part Number CGA4J1X7S1E106K125AE
D2: LED Rouge; LED_0805_2012Metric; Part Number APTD2012LSURCK
D5: MMSZ3V3T1G; D_SOD-123; Part Number MMSZ3V3T1G
J5: SeedStudio 110990037; SEEED_110990037; Part Number 110990037
J6: 72454-010VLF; IDC-Header_2x05_P2.54mm_Vertical_SMD; Part Number 72454-010VLF
J7, J8: DF3A-5P-2DS; SHDRRA5W60P0X200_1X5_1200X720X530P; Part Number DF3A-5P-2DS
J9: B2B-XH-2; JST_XH_B2B-XH-A_1x02_P2.50mm_Vertical; Part Number B2B-XH-2(LF)(SN)
J10: Cable Servomoteur JST; SolderWire-0.5sqmm_1x03_P4.8mm_D0.9mm_OD2.3mm; Part Number Cable JST Servo
JP5, JP6: Jumper_3_Open; SolderJumper-3_P1.3mm_Open_RoundedPad1.0x1.5mm
Q2: TPH2R506PL,L1Q; SOP-8_3.76x4.96mm_P1.27mm; Part Number TPH2R506PL,L1Q
R11, R21: 100R; R_0805_2012Metric; Part Number RT0805DRE07100RL
R12, R13: 4.7K; R_0805_2012Metric; Part Number RK73H2ATTD4701F
R14, R15: 4.7K; R_0805_2012Metric; Part Number RK73H2ATTD4701F; not fitted
R17: 750R; R_0805_2012Metric; Part Number RT0805BRD07750RL
R18: 18K; R_0805_2012Metric; Part Number RT0805FRE0718KL
R19, R22, R23: 10K; R_0805_2012Metric; Part Number RCA080510K0JNEASR
R20: 10R; R_0805_2012Metric; Part Number RT0805FRE1310RL
R25, R26: 15K; R_0805_2012Metric; Part Number RT0805DRE0715KL
TP1: TestPoint; PinHeader_1x03_P2.54mm_Vertical
TP2, TP3, TP4, TP5: TestPoint; PinHeader_1x01_P2.54mm_Vertical; not fitted
TP13, TP14: TestPoint; PinHeader_1x01_P2.54mm_Vertical
TP15: TestPoint; PinHeader_1x03_P2.54mm_Vertical; not fitted
U4: PCA9306DP; TSSOP-8_3x3mm_P0.65mm; Part Number PCA9306DP,118
U5: 74AHC1G126; SOT-23-5; Part Number SN74AHC1G126DBVR

Connections:
+3.3V: C25.1, J5.3, JP5.1 (A), JP6.1 (A), R12.1, R13.1, U4.2 (VREF1), U4.8 (EN); also elsewhere on the board
+5V: C27.2, J10.2, JP5.3 (B), JP6.3 (B), U5.1, U5.5 (VCC); also elsewhere on the board
+BATT: J9.1; also elsewhere on the board
/CPU/ALERT_LED: D2.2 (A); also elsewhere on the board
/CPU/CMD_CAMERA_LED: R20.1; also elsewhere on the board
/CPU/DEBUG_UART_RXD: TP15.3; also elsewhere on the board
/CPU/DEBUG_UART_TXD: TP15.2; also elsewhere on the board
/CPU/ENCODER_A_PHA: R22.1, R25.2; also elsewhere on the board
/CPU/ENCODER_B_PHA: R23.1, R26.2; also elsewhere on the board
/CPU/I2C_SCL: J5.1, R12.2, TP1.3, U4.3 (SCL1); also elsewhere on the board
/CPU/I2C_SDA: J5.2, R13.2, TP1.2, U4.4 (SDA1); also elsewhere on the board
/CPU/MESURE_ADC: C26.1, D5.1 (K), R18.2, R19.1, TP5.1; also elsewhere on the board
/CPU/ONOFF_IMX8MP: R11.2; also elsewhere on the board
/CPU/SERVO_PWM: U5.2; also elsewhere on the board
/IO/3V3_IMX8MP: J6.1, R14.1, R15.1, U4.7 (VREF2)
/IO/I2C3_SCL: J6.7, R14.2, U4.6 (SCL2)
/IO/I2C3_SDA: J6.9, R15.2, U4.5 (SDA2)
GND: C25.2, C26.2, D5.2 (A), J5.4, J6.6, J7.5, J8.5, R17.2, R19.2, R25.1, R26.1, TP1.1, TP13.1, TP15.1, U4.1 (GND), U5.3 (GND); also elsewhere on the board
GNDPWR: C27.1, J10.3, Q2.1 (S_1), Q2.2 (S_2), Q2.3 (S_3), TP14.1; also elsewhere on the board
unnamed: D2.1 (K), R17.1
unnamed: J6.4, R11.1
unnamed: J7.3, R22.2, TP3.1
unnamed: J8.3, R23.2, TP4.1
unnamed: J9.2, Q2.5 (D_1), Q2.6 (D_2), Q2.7 (D_3), Q2.8 (D_4)
unnamed: J10.1, R21.2, TP2.1
unnamed: J7.2, JP5.2 (C)
unnamed: J8.2, JP6.2 (C)
unnamed: Q2.4 (G), R20.2
unnamed: R21.1, U5.4
VCC: R18.1; also elsewhere on the board

Notes on the sheet:
Connecteur telemetre
ATTENTION Penser à relier le 5V ou 3V3
Mesure de la tension batterie
Remarque: Seul le signal PHA est utilisé (vers CTIMER0)
Visualisation
Connection vers FRDM-IMX8MP
Encodeur moteur B
Pilotage eclairage piste
vers connecteur J27 sur FRDM-IMX8MP
Les resistances de pull-up I2C3 sont placées sur la carte IMX8MP (à verifier)
Commande et protection servomoteur
Encodeur moteur A
Remarque: Seul le signal PHA est utilisé (vers CTIMER1)
Pullup I2C

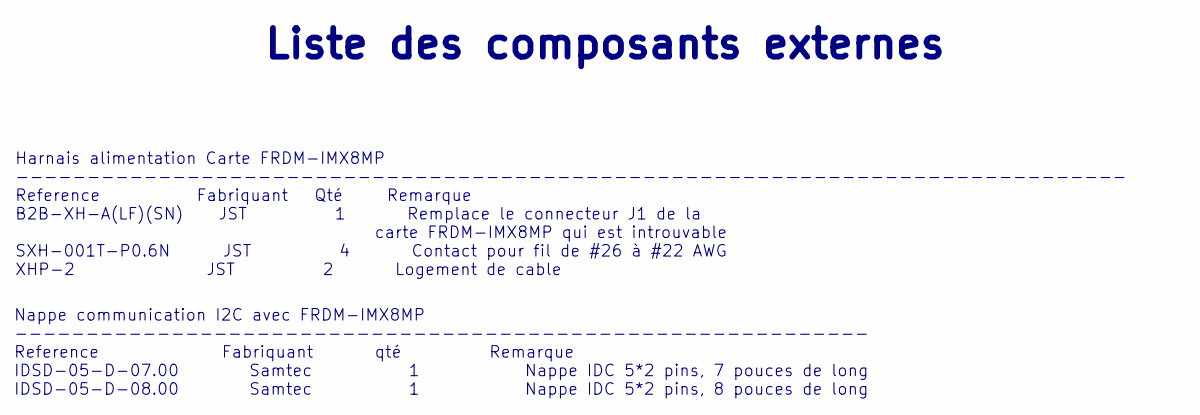
[picture p19: schematic Composants externes.kicad_sch]

Notes on the sheet:
Harnais alimentation Carte FRDM-IMX8MP ------------------------------------------------------------------------------ Reference Fabriquant Qté Remarque B2B-XH-A(LF)(SN) JST 1 Remplace le connecteur J1 de la carte FRDM-IMX8MP qui est introuvable SXH-001T-P0.6N JST 4 Contact pour fil de #26 à #22 AWG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
Nappe communication I2C avec FRDM-IMX8MP ------------------------------------------------------------ Reference Fabriquant qté Remarque IDSD-05-D-07.00 Samtec 1 Nappe IDC 5*2 pins, 7 pouces de long IDSD-05-D-08.00 Samtec 1 Nappe IDC 5*2 pins, 8 pouces de long
Liste des composants externes

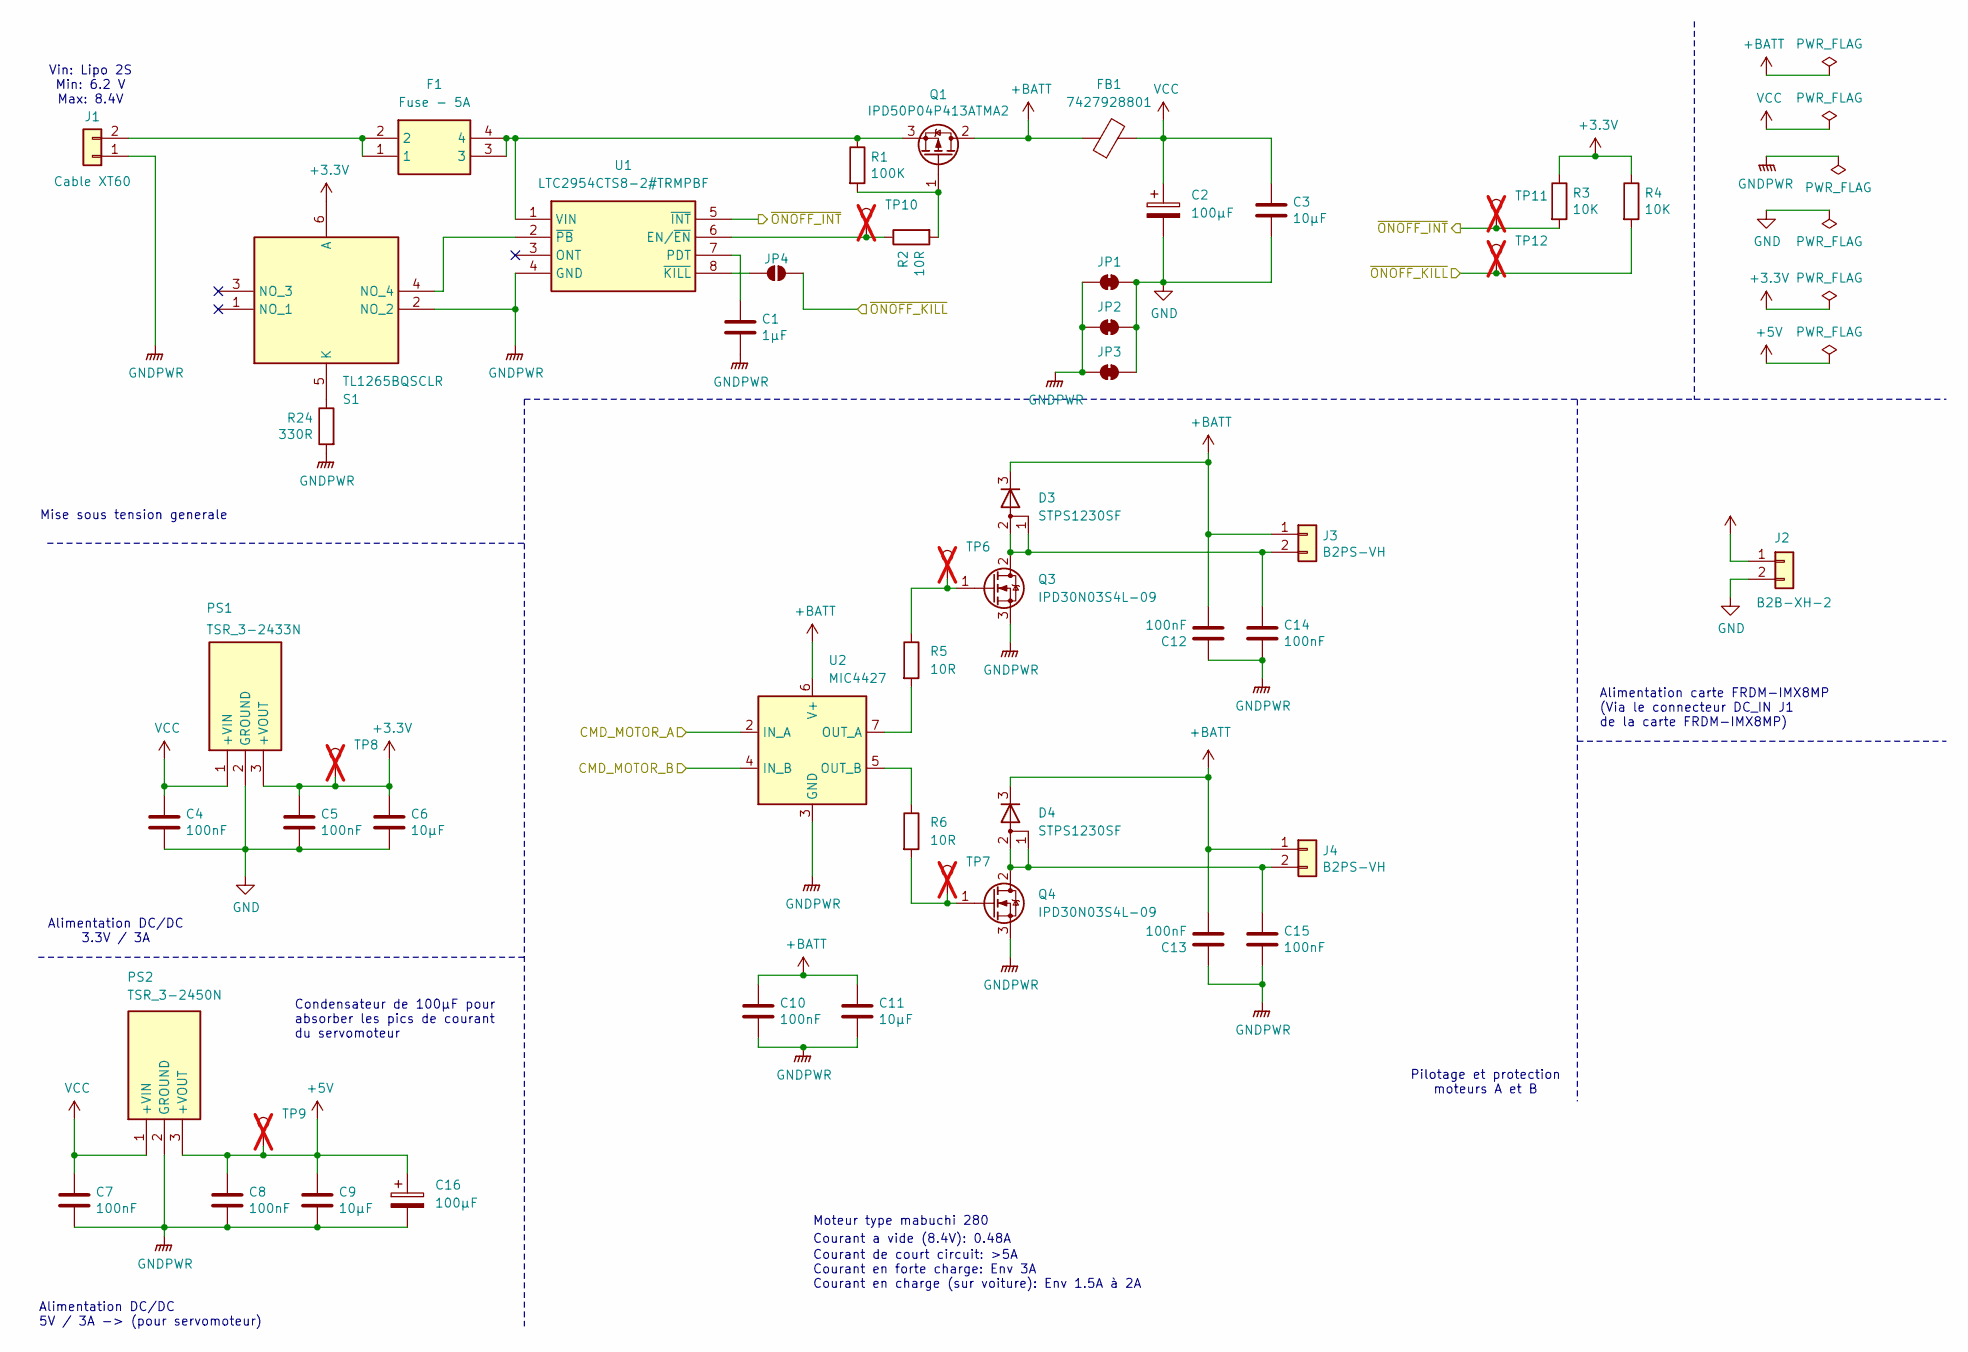
[picture p20: schematic puissance.kicad_sch]

Parts:
C1: 1µF; C_0805_2012Metric; Part Number CL21B105KBFNNNF
C2, C16: 100µF; CP_Elec_10x10; Part Number EMVH500ARA101MJA0G
C3, C6, C9, C11: 10µF; C_0805_2012Metric; Part Number CGA4J1X7S1E106K125AE
C4, C5, C7, C8, C10, C12, C13, C14, C15: 100nF; C_0805_2012Metric; Part Number CL21B104KBFNNNG
D3, D4: STPS1230SF; TO-277A; Part Number STPS1230SF
F1: Fuse - 5A; 3568; Part Number 3568
FB1: 7427928801; C_2220_5750Metric; Part Number 7427928801
J1: Cable XT60; Battery_Pads; Part Number Cable batterie XT60
J2: B2B-XH-2; JST_XH_B2B-XH-A_1x02_P2.50mm_Vertical; Part Number B2B-XH-2(LF)(SN)
J3, J4: B2PS-VH; JST_VH_B2PS-VH_1x02_P3.96mm_Horizontal; Part Number B2PS-VH(LF)(SN)
JP1, JP2, JP3: SolderJumper_2_Bridged; SolderJumper-2_P1.3mm_Bridged2Bar_RoundedPad1.0x1.5mm
JP4: SolderJumper_2_Open; SolderJumper-2_P1.3mm_Open_RoundedPad1.0x1.5mm
PS1: TSR_3-2433N; TSR324xxN; Part Number TSR_3-2433N
PS2: TSR_3-2450N; TSR324xxN; Part Number TSR_3-2450N
Q1: IPD50P04P413ATMA2; TO-252-2; Part Number IPD50P04P413ATMA2
Q3, Q4: IPD30N03S4L-09; TO-252-2; Part Number IPD30N03S4L-09
R1: 100K; R_0805_2012Metric; Part Number RT0805FRE10100KL
R2, R5, R6: 10R; R_0805_2012Metric; Part Number RT0805FRE1310RL
R3, R4: 10K; R_0805_2012Metric; Part Number RCA080510K0JNEASR
R24: 330R; R_0805_2012Metric; Part Number RT0805DRD07330RL
S1: TL1265BQSCLR; Mouser Part Number 612-TL1265BQSCLR
TP6, TP7, TP8, TP9, TP10, TP11, TP12: TestPoint; PinHeader_1x01_P2.54mm_Vertical; not fitted
U1: LTC2954CTS8-2#TRMPBF; SOT-23-8; Part Number LTC2954CTS8-2#TRPBF
U2: MIC4427; SO-8_3.9x4.9mm_P1.27mm; Part Number MIC4427ZM

Connections:
+3.3V: C5.1, C6.1, PS1.3 (+VOUT), R3.1, R4.1, S1.6 (A), TP8.1; also elsewhere on the board
+5V: C8.1, C9.1, C16.1, PS2.3 (+VOUT), TP9.1; also elsewhere on the board
+BATT: C10.1, C11.1, C12.2, C13.2, D3.3 (K), D4.3 (K), FB1.1, J3.1, J4.1, Q1.2 (D), U2.6 (V+); also elsewhere on the board
/CPU/MOTOR_A_PWM: U2.2 (IN_A); also elsewhere on the board
/CPU/MOTOR_B_PWM: U2.4 (IN_B); also elsewhere on the board
/CPU/~ONOFF_INT: R3.2, TP11.1, U1.5 (~INT); also elsewhere on the board
/CPU/~ONOFF_KILL: JP4.2 (B), R4.2, TP12.1; also elsewhere on the board
GND: C2.2, C3.2, C4.2, C5.2, C6.2, J2.2, JP1.2 (B), JP2.2 (B), JP3.2 (B), PS1.2 (GROUND); also elsewhere on the board
GNDPWR: C1.2, C7.2, C8.2, C9.2, C10.2, C11.2, C12.1, C13.1, C14.2, C15.2, C16.2, J1.1, JP1.1 (A), JP2.1 (A), JP3.1 (A), PS2.2 (GROUND), Q3.3 (S), Q4.3 (S), R24.2, S1.2 (NO_2), U1.4 (GND), U2.3 (GND); also elsewhere on the board
unnamed: F1.1, F1.2, J1.2
unnamed: C14.1, D3.1 (A), D3.2 (A), J3.2, Q3.2 (D)
unnamed: C15.1, D4.1 (A), D4.2 (A), J4.2, Q4.2 (D)
unnamed: JP4.1 (A), U1.8 (~KILL)
unnamed: Q1.1 (G), R1.2, R2.2
unnamed: F1.3, F1.4, Q1.3 (S), R1.1, U1.1 (VIN)
unnamed: Q3.1 (G), R5.1, TP6.1
unnamed: Q4.1 (G), R6.2, TP7.1
unnamed: R24.1, S1.5 (K)
unnamed: S1.4 (NO_4), U1.2 (~PB)
unnamed: R2.1, TP10.1, U1.6 (EN/~EN)
unnamed: C1.1, U1.7 (PDT)
unnamed: R5.2, U2.7 (OUT_A)
unnamed: R6.1, U2.5 (OUT_B)
VCC: C2.1, C3.1, C4.1, C7.1, FB1.2, J2.1, PS1.1 (+VIN), PS2.1 (+VIN); also elsewhere on the board

Notes on the sheet:
Alimentation DC/DC 3.3V / 3A
Alimentation carte FRDM-IMX8MP (Via le connecteur DC_IN J1 de la carte FRDM-IMX8MP)
Mise sous tension generale
Vin: Lipo 2S Min: 6.2 V Max: 8.4V
Courant de court circuit: >5A Courant en forte charge: Env 3A Courant en charge (sur voiture): Env 1.5A à 2A
Condensateur de 100µF pour absorber les pics de courant du servomoteur
Alimentation DC/DC 5V / 3A -> (pour servomoteur)
Moteur type mabuchi 280
Courant a vide (8.4V): 0.48A
Pilotage et protection moteurs A et B

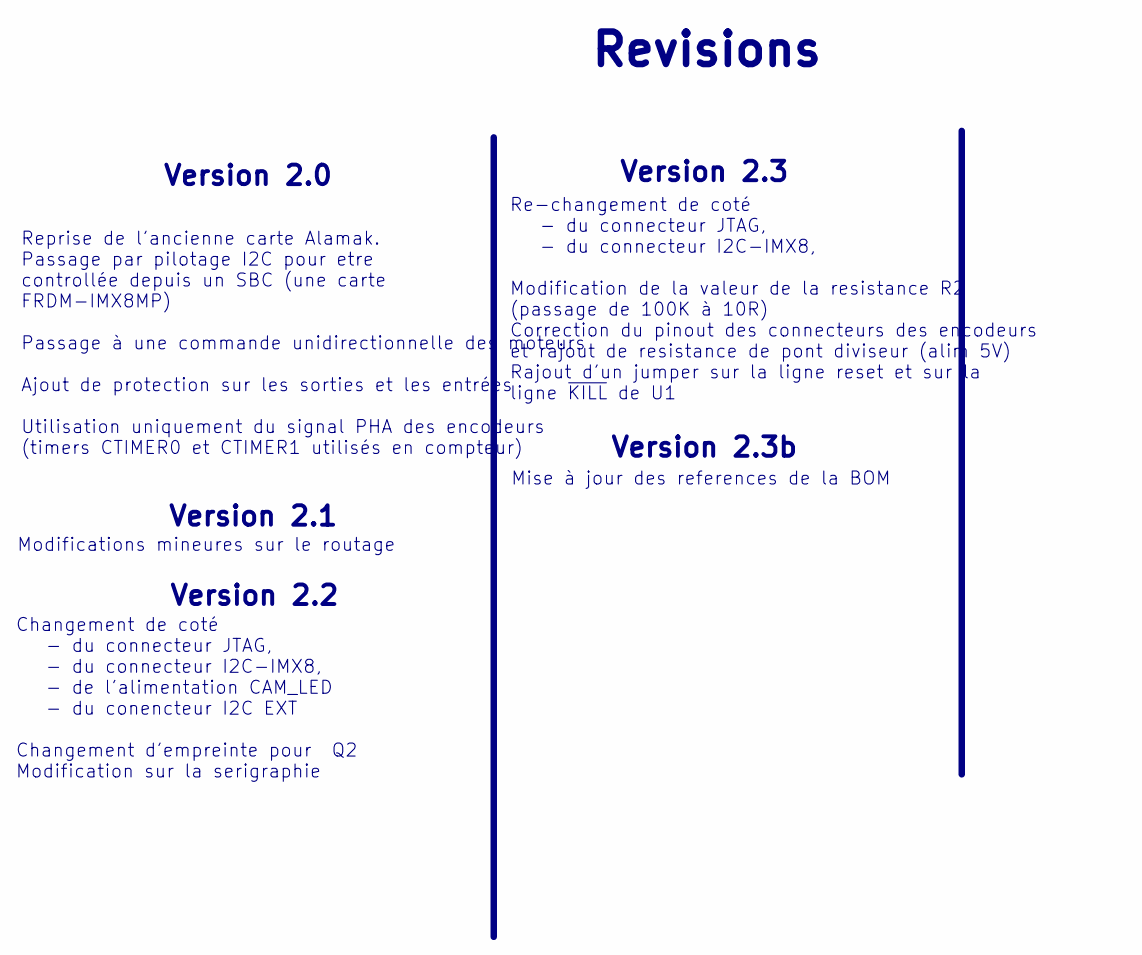
[picture p21: schematic revisions.kicad_sch]

Notes on the sheet:
Version 2.2
Mise à jour des references de la BOM
Version 2.3b
Version 2.1
Modifications mineures sur le routage
Version 2.3
Re-changement de coté - du connecteur JTAG, - du connecteur I2C-IMX8, Modification de la valeur de la resistance R2 (passage de 100K à 10R) Correction du pinout des connecteurs des encodeurs et rajout de resistance de pont diviseur (alim 5V) Rajout d'un jumper sur la ligne reset et sur la ligne ~{K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
Reprise de l'ancienne carte Alamak. Passage par pilotage I2C pour etre controllée depuis un SBC (une carte FRDM-IMX8MP) Passage à une commande unidirectionnelle des moteurs Ajout de protection sur les sorties et les entrées Utilisation uniquement du signal PHA des encodeurs (timers CTIMER0 et CTIME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
Version 2.0
Changement de coté - du connecteur JTAG, - du connecteur I2C-IMX8, - de l'alimentation CAM_LED - du conencteur I2C EXT Changement d'empreinte pour Q2 Modification sur la serigraphie
Revisions

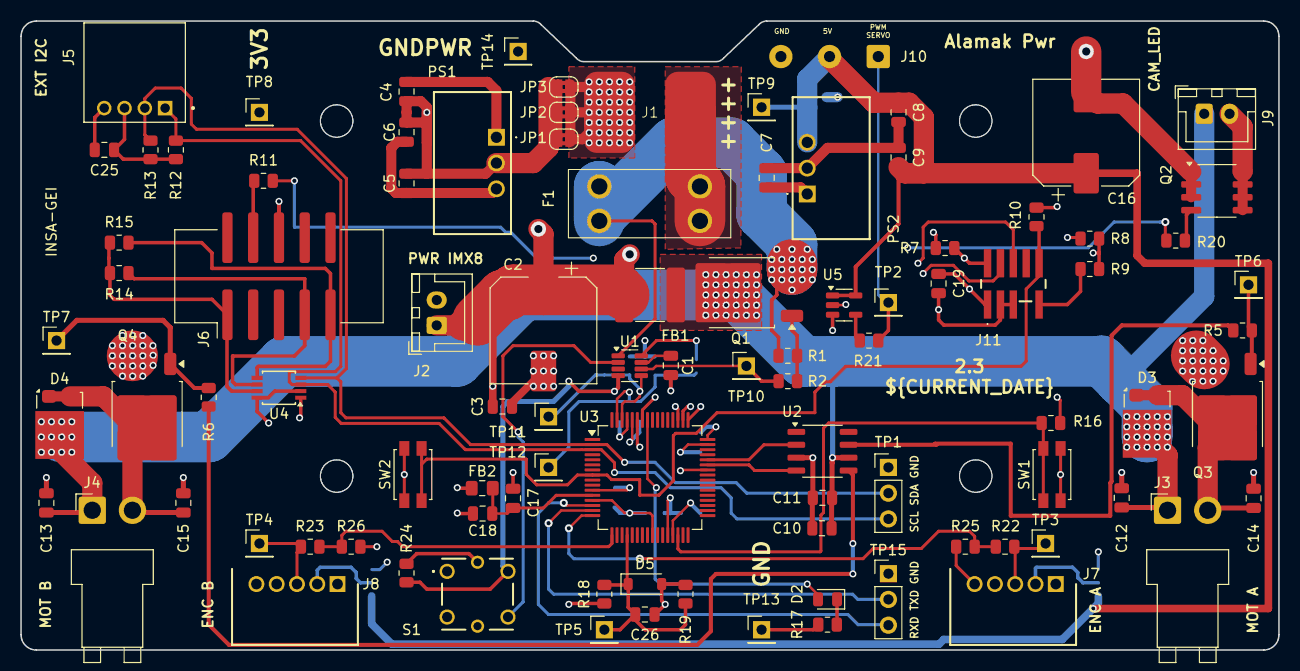
[picture p22: board Carte_puissance.kicad_pcb from above]

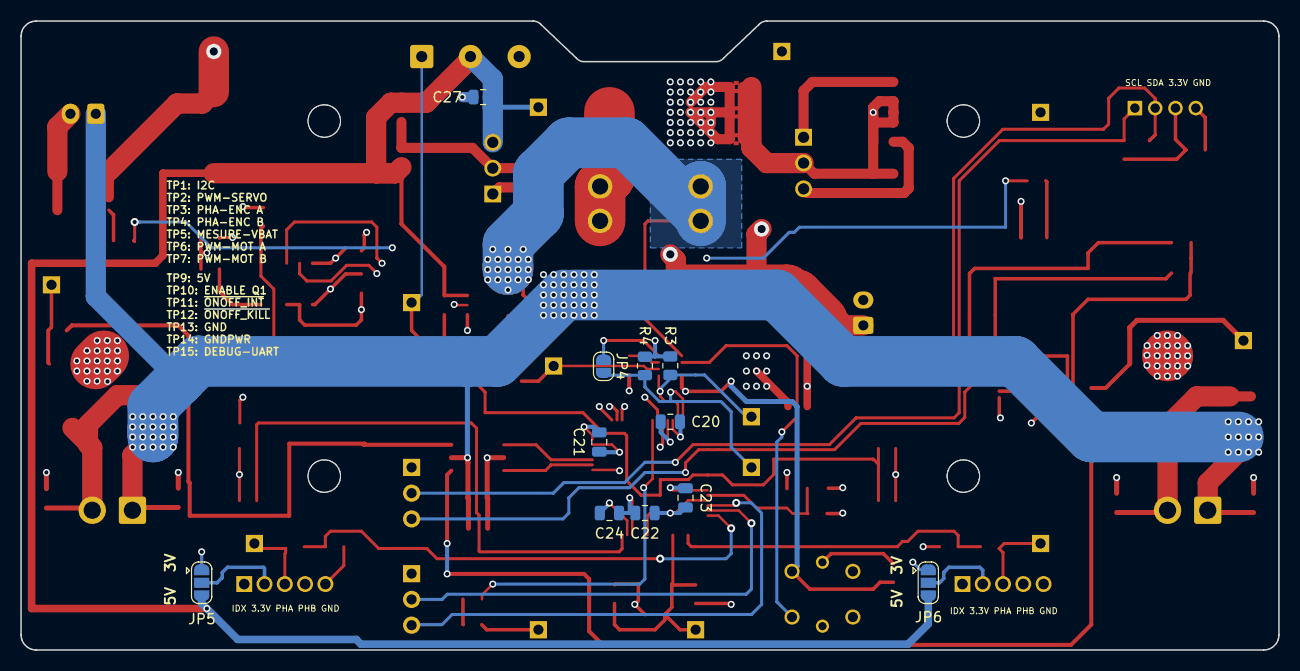
[picture p23: board Carte_puissance.kicad_pcb from below]

Board: 4 copper layers, 124.0 x 62.0 mm, 110 parts (11 on the bottom side), 55 nets.
