INSA-GEI/gei-nxpcup-4w-pwr/software/alamak_fw_power/drivers/fsl_eqdc.h

/*
 * Copyright 2022, 2023 NXP
 *
 * SPDX-License-Identifier: BSD-3-Clause
 */

#ifndef FSL_EQDC_H_
#define FSL_EQDC_H_

#include "fsl_common.h"

/*!
 * @addtogroup eqdc
 * @{
 */

/*******************************************************************************
 * Definitions
 ******************************************************************************/
#define FSL_EQDC_DRIVER_VERSION (MAKE_VERSION(2, 3, 1))

/*! @brief W1C bits in EQDC CTRL registers. */
#define EQDC_CTRL_W1C_FLAGS (EQDC_CTRL_HIRQ_MASK | EQDC_CTRL_XIRQ_MASK | EQDC_CTRL_WDIRQ_MASK)

/*! @brief W1C bits in EQDC INTCTRL registers. */
#define EQDC_INTCTRL_W1C_FLAGS                                                                                 \
    (EQDC_INTCTRL_SABIRQ_MASK | EQDC_INTCTRL_DIRIRQ_MASK | EQDC_INTCTRL_RUIRQ_MASK | EQDC_INTCTRL_ROIRQ_MASK | \
     EQDC_INTCTRL_CMP0IRQ_MASK | EQDC_INTCTRL_CMP1IRQ_MASK | EQDC_INTCTRL_CMP2IRQ_MASK | EQDC_INTCTRL_CMP3IRQ_MASK)

/*! @brief Interrupt enable bits in EQDC CTRL registers. */
#define EQDC_CTRL_INT_EN (EQDC_CTRL_HIE_MASK | EQDC_CTRL_XIE_MASK | EQDC_CTRL_WDIE_MASK)

/*! @brief Interrupt enable bits in EQDC INTCTRL registers. */
#if (defined(FSL_FEATURE_EQDC_HAS_NO_COMPARE_INTERRUPT) && FSL_FEATURE_EQDC_HAS_NO_COMPARE_INTERRUPT)
#define EQDC_INTCTRL_INT_EN                                                                                \
    (EQDC_INTCTRL_SABIE_MASK | EQDC_INTCTRL_DIRIE_MASK | EQDC_INTCTRL_RUIE_MASK | EQDC_INTCTRL_ROIE_MASK)
#else
#define EQDC_INTCTRL_INT_EN                                                                                \
    (EQDC_INTCTRL_SABIE_MASK | EQDC_INTCTRL_DIRIE_MASK | EQDC_INTCTRL_RUIE_MASK | EQDC_INTCTRL_ROIE_MASK | \
     EQDC_INTCTRL_CMP0IE_MASK | EQDC_INTCTRL_CMP1IE_MASK | EQDC_INTCTRL_CMP2IE_MASK | EQDC_INTCTRL_CMP3IE_MASK)
#endif

/*! @brief Interrupt flag bits in EQDC CTRL registers. */
#define EQDC_CTRL_INT_FLAGS (EQDC_CTRL_HIRQ_MASK | EQDC_CTRL_XIRQ_MASK | EQDC_CTRL_WDIRQ_MASK)

/*! @brief Interrupt flag bits in EQDC INTCTRL registers. */
#define EQDC_INTCTRL_INT_FLAGS                                                                                 \
    (EQDC_INTCTRL_SABIRQ_MASK | EQDC_INTCTRL_DIRIRQ_MASK | EQDC_INTCTRL_RUIRQ_MASK | EQDC_INTCTRL_ROIRQ_MASK | \
     EQDC_INTCTRL_CMP0IRQ_MASK | EQDC_INTCTRL_CMP1IRQ_MASK | EQDC_INTCTRL_CMP2IRQ_MASK | EQDC_INTCTRL_CMP3IRQ_MASK)

#if !(defined(FSL_FEATURE_EQDC_HAS_NO_COMPARE_INTERRUPT) && FSL_FEATURE_EQDC_HAS_NO_COMPARE_INTERRUPT)
#define kEQDC_PositionCompare0InerruptEnable kEQDC_PositionCompare0InterruptEnable
#define kEQDC_PositionCompare1InerruptEnable kEQDC_PositionCompare1InterruptEnable
#define kEQDC_PositionCompare2InerruptEnable kEQDC_PositionCompare2InterruptEnable
#define kEQDC_PositionCompare3InerruptEnable kEQDC_PositionCompare3InterruptEnable
#endif
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
