INSA-GEI/gei-nxpcup-4w-pwr/(commit log)

2026-05-13 chore: add KiCad ignores, LFS attributes, and project directories
    Agent-Logs-Url: https://github.com/INSA-GEI/gei-nxpcup-4w-pwr/sessions/bccda065-d94e-435e-a597-74c599226170
2026-05-21 WIP schema terminé, empreintes de composants verifié, reste à faire les verifications
    [Carte_puissance.kicad_sch, cpu.kicad_sch, io.kicad_sch]
2026-05-27 Wip carte alamk pwr 2.0 prete pour tirage
    [Carte_puissance-B_Cu.gbr, Carte_puissance-B_Mask.gbr, Carte_puissance-B_Paste.gbr, Carte_puissance-B_Silkscreen.gbr, Carte_puissance-Edge_Cuts.gbr, Carte_puissance-F_Cu.gbr, Carte_puissance-F_Mask.gbr, Carte_puissance-F_Paste.gbr]
2026-05-28 Wip correction sur le connecteur debug et realisation d'un soft de test pour verifier le mapping des fonctions sur les pins
    [Carte_puissance.kicad_pcb, cpu.kicad_sch]
2026-06-19 Code MCXA153 en cours de dev, les fonctions sont gobalement implementées
2026-08-28 version 1 beta du fw
    [configuration.h]
2026-09-22 version 2.3 de la carte pwr: ajout de bouton, reorganisation de connecteur
2026-09-22 Erreur de manipulation, version 2.3 ok
2026-09-22 V2.3b: correction sur la nomenclature (bom) de plusieurs composants, suppression d'une mauvaise manipulation precedente
2026-10-14 Corrections sur la carte puissance
